parsaileslamlou/Insole/figures/demo/heatmap_sim_walk.gif

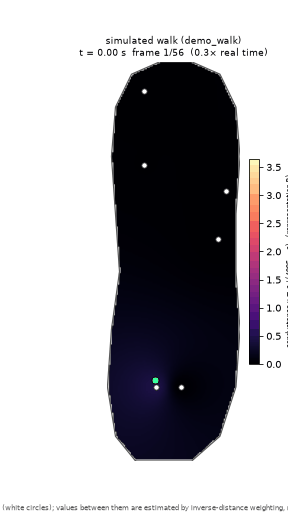
figures/demo/heatmap_sim_walk.gif
