parsaileslamlou/Insole/figures/hardware/board_carrier.jpg

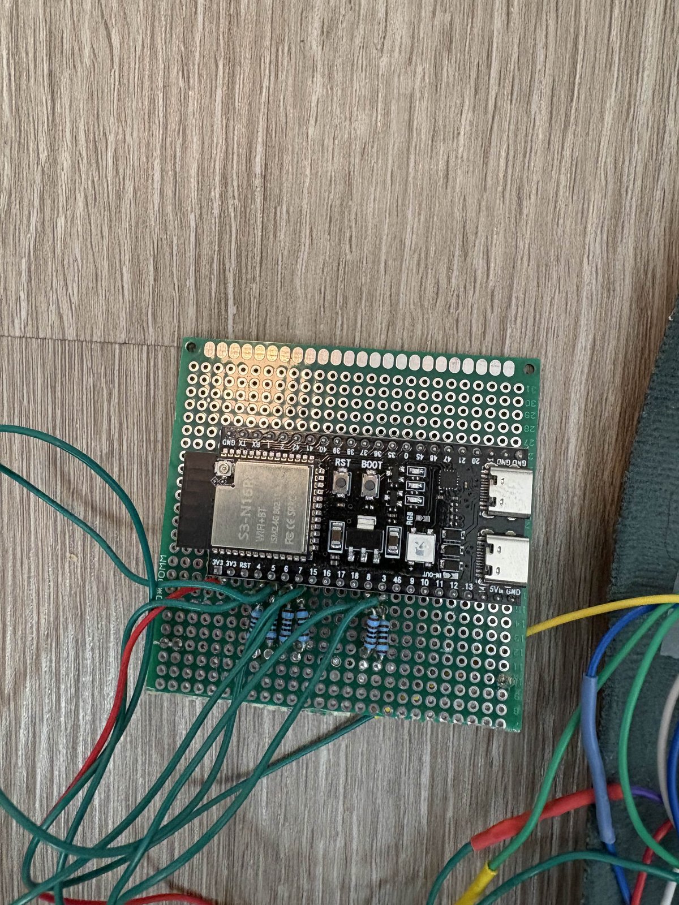
figures/hardware/board_carrier.jpg
