parsaileslamlou/Insole/figures/hardware/insole_sensors.jpg

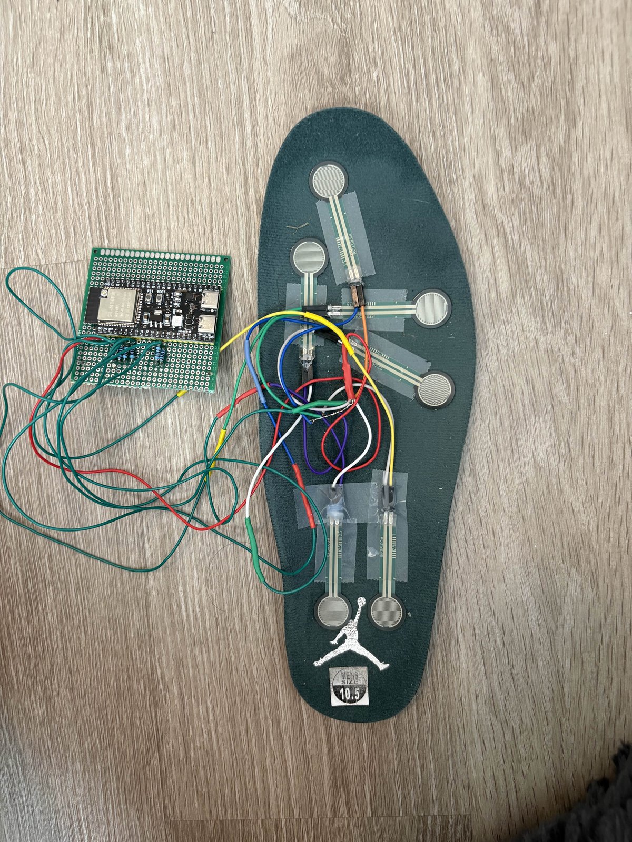
figures/hardware/insole_sensors.jpg
