parsaileslamlou/Insole/figures/sim_vs_real/fast.png

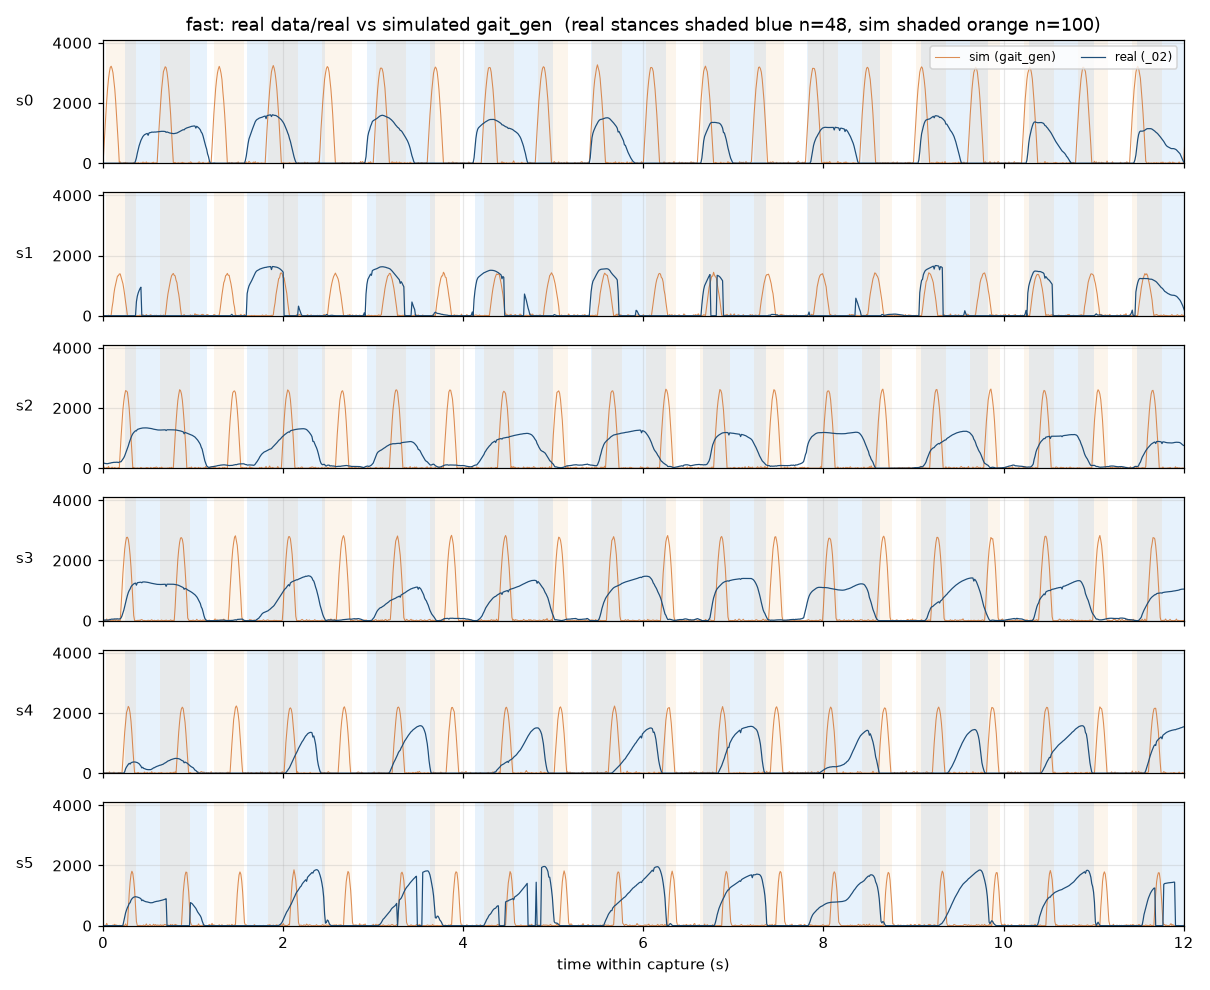
figures/sim_vs_real/fast.png
