parsaileslamlou/Insole/figures/sim_vs_real/shuffle.png

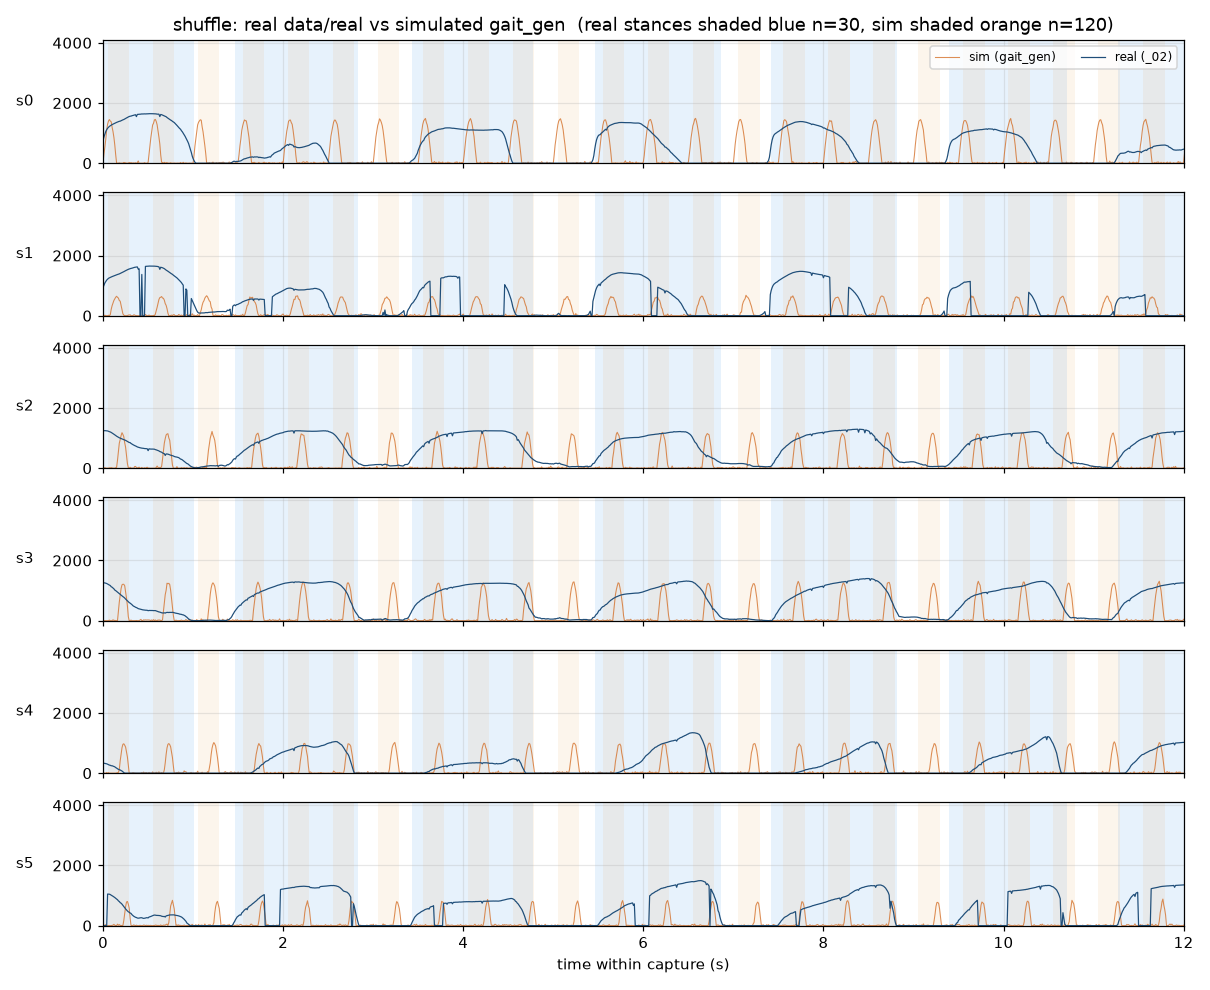
figures/sim_vs_real/shuffle.png
