parsaileslamlou/Insole/figures/sim_vs_real/stand.png

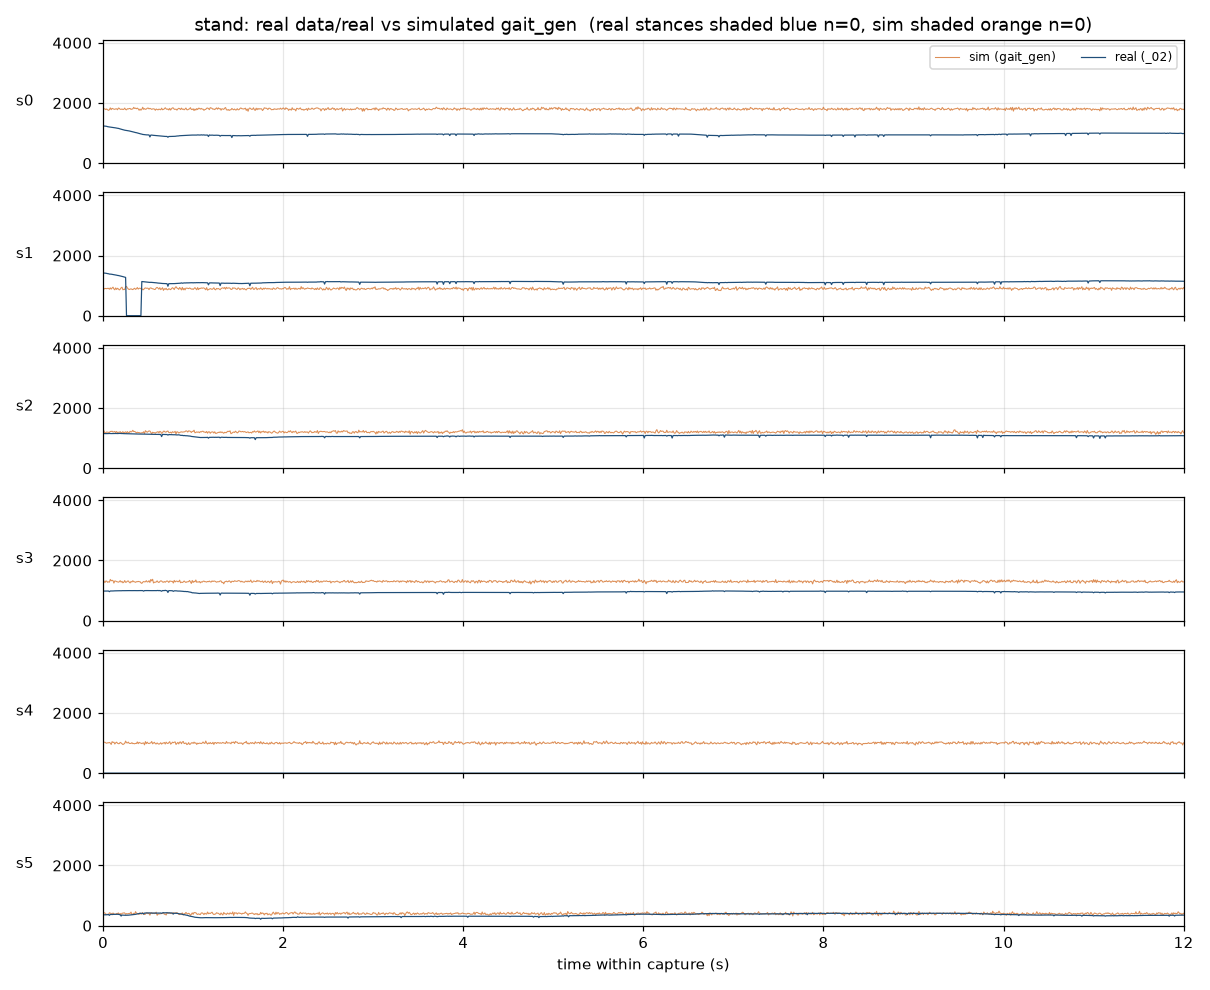
figures/sim_vs_real/stand.png
