parsaileslamlou/Insole/figures/sim_vs_real/walk.png

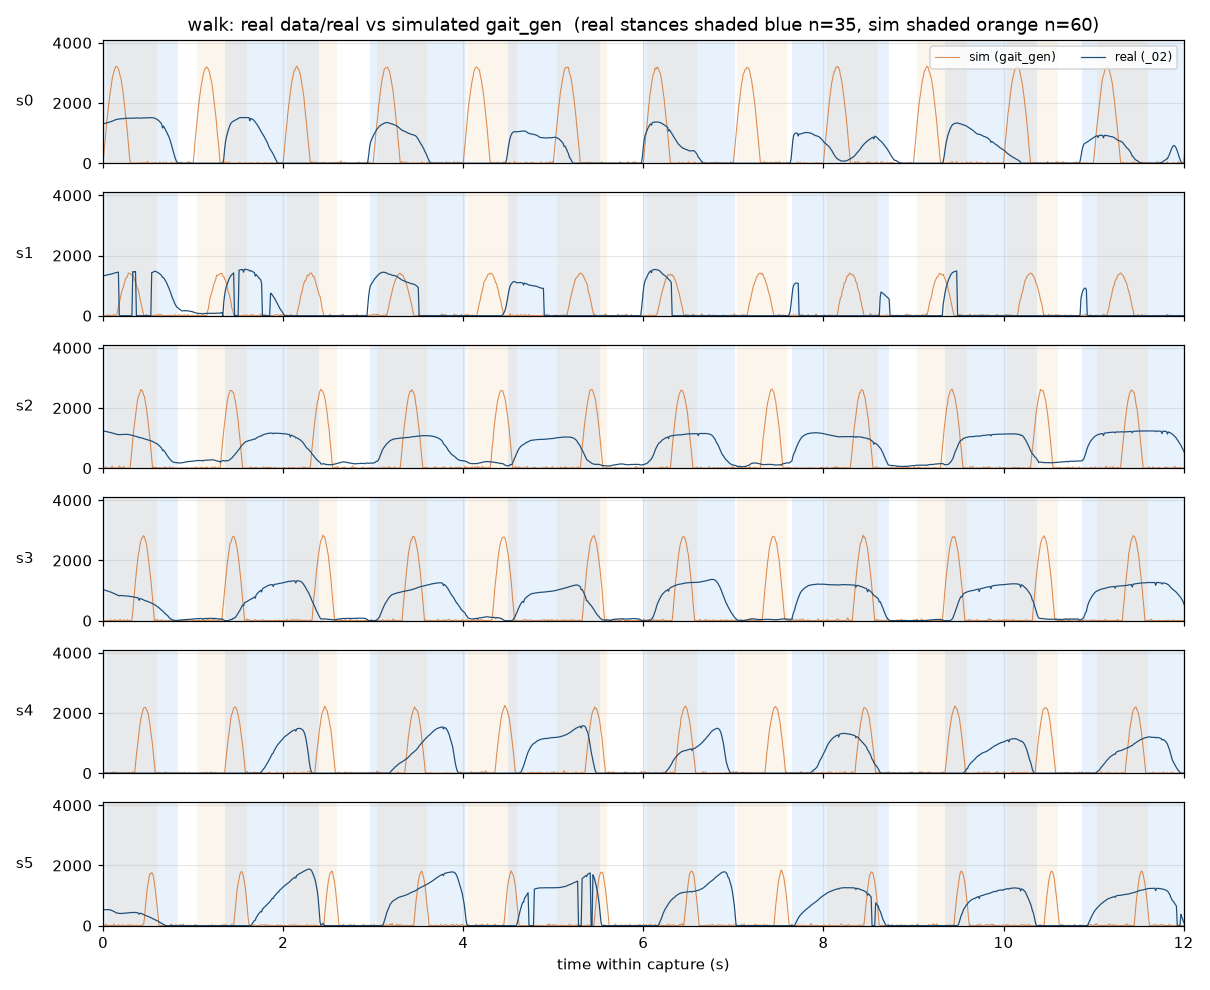
figures/sim_vs_real/walk.png
