parsaileslamlou/Insole/cal_data/calibration_manifest.csv

0 | 0 | cal_s0_t0.csv | 0.0 | 0.0 | 0.0 | 0.0 | 200 | 0.0 | 0.0 | 0.0 | 2026-09-01T19:59:04-04:00
1 | 0 | cal_s1_t0.csv | 0.0 | 0.0 | 0.0 | 0.0 | 200 | 0.0 | 0.0 | 0.0 | 2026-09-01T19:59:12-04:00
2 | 0 | cal_s2_t0.csv | 0.0 | 0.0 | 0.0 | 0.0 | 200 | 0.0 | 0.0 | 0.0 | 2026-09-01T19:59:20-04:00
3 | 0 | cal_s3_t0.csv | 0.0 | 0.0 | 0.0 | 0.0 | 200 | 0.035 | 0.3527 | 0.0 | 2026-09-01T19:59:27-04:00
4 | 0 | cal_s4_t0.csv | 0.0 | 0.0 | 0.0 | 0.0 | 200 | 0.05 | 0.5824 | 0.0 | 2026-09-01T19:59:46-04:00
5 | 0 | cal_s5_t0.csv | 0.0 | 0.0 | 0.0 | 0.0 | 200 | 0.0 | 0.0 | 0.0 | 2026-09-01T20:00:01-04:00
0 | 1 | cal_s0_t1.csv | 664.0 | 683.0 | 6.607035000000001 | 0.05380615833712719 | 200 | 417.825 | 13.0893 | 0.0 | 2026-09-01T20:01:03-04:00
1 | 1 | cal_s1_t1.csv | 652.0 | 668.0 | 6.474600000000001 | 0.04531044912600184 | 200 | 416.66 | 8.4034 | 0.0 | 2026-09-01T20:01:54-04:00
2 | 1 | cal_s2_t1.csv | 598.0 | 631.0 | 6.028245000000001 | 0.09345280132237878 | 200 | 442.645 | 8.446 | 0.0 | 2026-09-01T20:03:03-04:00
3 | 1 | cal_s3_t1.csv | 518.0 | 531.0 | 5.145345000000001 | 0.03681473991487649 | 200 | 476.47 | 8.0806 | 0.0 | 2026-09-01T20:06:47-04:00
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
