parsaileslamlou/Insole/insole/read_serial.py

"""
read_serial.py — host logger for the insole.

Three line sources behind one seam:
    "serial"  live USB CDC          (pyserial)
    "file"    replay a saved capture
    "ble"     live Nordic UART      (bleak)

Everything below make_source() is transport-agnostic: it consumes an iterator
of strings and does not know or care where they came from.

    pip install pyserial bleak

Usage:
    python -m insole.read_serial                          live BLE  -> readings.csv
    python -m insole.read_serial --source ble    out.csv  live BLE  -> out.csv
    python -m insole.read_serial --source serial out.csv  live USB  -> out.csv
    python -m insole.read_serial --source serial --port COM13 --duration 30 out.csv
    python -m insole.read_serial in.txt out.csv           replay a saved capture
    python -m insole.read_serial --source file in.txt out.csv

--port and --duration override PORT and DURATION_S for one run, so a machine
whose board enumerates on a different COM port needs no local edit to this
file.

Both paths are optional. --source defaults to "file" when an input path is
given and "ble" otherwise, so the notebook's
`python -m insole.read_serial data/sim/sim_walk.txt data/sim/sim_walk.csv`
works with no flags.

A live source has no input path, so its single positional is the OUTPUT --
that is what lets compare_captures.py run two captures side by side. --source
has to be given explicitly in that case, because a bare positional still means
"replay this file" and always did.
"""

import sys
import os
import time
import csv
import argparse

# ---------------------------------------------------------------------------
# Configuration. These are DEFAULTS for the CLI below, not the live values.
# The line sources take `duration_s=None` / `port=None` and resolve the module
# attribute AT CALL TIME. An earlier version used `duration_s=DURATION_S` as
# the default argument, which binds at import: assigning
# read_serial.DURATION_S afterwards then changed the runaway guard in main()
# but NOT the capture length, because make_source() had already captured 60.
# That trap is closed by _resolve() below; do not reintroduce it.
# ---------------------------------------------------------------------------
DEFAULT_SOURCE = "ble"      # "serial" | "file" | "ble"

PORT       = "COM7"         # --source serial
BAUD       = 921600
IN_FILE    = "capture.txt"  # --source file, when no in_path is given
BLE_NAME   = "INSOLE"       # --source ble

DURATION_S = 60
OUT_CSV    = "readings.csv"

PERIOD_US  = 10000          # 100 Hz, must match firmware
TIMING_TOL_US = 3000        # how far a gap may stray from its expected value

# Occasional radio drops are normal over BLE and are NOT a defect. Corrupted
# or malformed frames are, on every transport. See exit_code() below.
BLE_LOSS_TOLERANCE_PCT = 2.0

# Data-inactivity watchdog for LIVE sources. A board that stops sending while
# the link stays up -- firmware wedged, radio associated but silent, USB CDC
# stalled -- produces no line, so no counter moves and no check in exit_code()
# can see it. The capture would sit until DURATION_S expires and then exit 0
# with a clean but short file, which is the dataset-ruining mode. Each live
# source raises StallError when no line has arrived for this long. File replay
# is exempt: a file cannot stall.
STALL_S = 3.0

NUS_TX_UUID = "6e400003-b5a3-f393-e0a9-e50e24dcca9e"

SENSOR_COLS = ["s0", "s1", "s2", "s3", "s4", "s5"]
CSV_HEADER  = ["seq", "ts_us"] + SENSOR_COLS

# Lines a source produced but could not hand to the consumer. Raised by any
# source that has a producer thread and a hand-off queue between it and main();
# ble_lines is the only one with such a queue today, but nothing about this is
# BLE-specific and main() prints it without knowing which transport filled it.
# A dict rather than a plain int so a source can mutate it without needing a
# `global` declaration. Reset by main().
SOURCE_DROPS = {"n": 0}


# ---------------------------------------------------------------------------
# Line sources
# ---------------------------------------------------------------------------
class StallError(RuntimeError):
    """A live source produced no line for STALL_S seconds.

    Raised from inside the source generator, so it surfaces in the consumer's
    for-loop and cannot be swallowed by a counter that never moved.
    """


def _resolve(value, default):
    """Call-time default: None means 'whatever the module attribute is now'."""
    return default if value is None else value


def serial_lines(port=None, baud=None, duration_s=None, stall_s=None):
    import serial
    port = _resolve(port, PORT)
    baud = _resolve(baud, BAUD)
    duration_s = _resolve(duration_s, DURATION_S)
    stall_s = _resolve(stall_s, STALL_S)
    # readline() returns b"" after `timeout` seconds of silence; the stall
    # check has to be coarser than that or every quiet second would trip it.
    ser = serial.Serial(port, baud, timeout=min(1.0, stall_s))
    ser.reset_input_buffer()
    t_warm = time.time()
    while time.time() - t_warm < 1.0:      # discard boot chatter
        ser.readline()
    t0 = time.time()
    t_data = t0
    try:
        while time.time() - t0 < duration_s:
            raw = ser.readline()
            if not raw:
                if time.time() - t_data > stall_s:
                    raise StallError(
                        f"serial {port}: no data for {stall_s:.1f}s "
                        f"(port open, board silent)")
                continue
            t_data = time.time()
            yield raw.decode("ascii", errors="ignore").strip()
    finally:
        ser.close()


def file_lines(path):
    with open(path, "r") as f:
        for raw in f:
            yield raw.strip()


def ble_lines(device_name=None, duration_s=None, stall_s=None, _runner=None):
    """Live BLE source.

    All asyncio and threading is confined to this function. It returns a plain
    synchronous generator of strings, exactly like the other two sources.

    `_runner` replaces the BLE session with a caller-supplied coroutine taking
    the output queue. It exists so the failure path below can be exercised
    without a radio, and without bleak installed; nothing in the capture path
    passes it.

    Reassembly contract:
      * A notification may carry several whole lines, one line, or a fragment
        of a line. Nothing may be assumed about alignment.
      * Bytes accumulate in `buf`. We emit only up to the LAST newline in the
        buffer; whatever follows stays buffered until more bytes arrive.
      * At disconnect the trailing partial line is DISCARDED, never emitted.
        Emitting it would produce a short frame that fails the checksum and
        looks like corruption.
      * The hand-off to the consumer never blocks. If the queue is full the
        line is dropped and counted in SOURCE_DROPS, never waited on.
    """
    import asyncio
    import threading
    import queue as _queue

    device_name = _resolve(device_name, BLE_NAME)
    duration_s = _resolve(duration_s, DURATION_S)
    stall_s = _resolve(stall_s, STALL_S)

    out = _queue.Queue(maxsize=20000)
    SENTINEL = object()

    async def _run():
        # Imported here rather than at the top of ble_lines() so a caller that
        # supplies _runner never needs bleak on the machine.
        from bleak import BleakScanner, BleakClient

        buf = bytearray()

        def on_notify(_handle, data):
            buf.extend(data)
            nl = buf.rfind(b"\n")
            if nl < 0:
                return                       # no complete line yet — wait
            chunk = bytes(buf[:nl + 1])
            del buf[:nl + 1]                 # keep the partial tail
            for raw in chunk.split(b"\n"):
                if not raw:
                    continue
                try:
                    out.put_nowait(
                        raw.decode("ascii", errors="ignore").strip())
                except _queue.Full:
                    # This runs on the asyncio event-loop thread. The
                    # blocking put() that used to be here would stall
                    # that thread, which stops notifications being
                    # serviced -- so a stalled consumer costs frames
                    # either way. The difference is that blocking loses
                    # them invisibly, as a gap indistinguishable from
                    # radio loss, while this loses them with a number
                    # attached. maxsize=20000 is ~200 s at 100 Hz, so a
                    # 60 s capture should never reach here; if it does,
                    # the consumer is the problem and the count says so.
                    #
                    # These lines still show up downstream as seq gaps,
                    # so they are already gated by the normal loss
                    # check. The counter is what separates "the radio
                    # dropped them" from "we dropped them ourselves".
                    SOURCE_DROPS["n"] += 1

        # Discovery is timed and reported separately from the capture. It can
        # burn the full 15 s, and charging that against the capture window is
        # what used to make a requested 60 s run quietly yield far less.
        t_scan0 = time.monotonic()
        dev = await BleakScanner.find_device_by_name(device_name, timeout=15.0)
        scan_s = time.monotonic() - t_scan0
        if dev is None:
            print(f"BLE: no device named {device_name!r} found "
                  f"(scanned {scan_s:.1f}s)")
            return

        disconnected = asyncio.Event()

        def on_disconnect(_client):
            disconnected.set()

        async with BleakClient(dev, disconnected_callback=on_disconnect) as client:
            try:
                mtu = client.mtu_size
            except Exception:
                mtu = "unavailable"
            print(f"BLE: connected to {device_name} after {scan_s:.1f}s "
                  f"discovery, negotiated MTU = {mtu}")

            # The notify window opens here, AFTER discovery and connect, so it
            # gets the full duration_s it was asked for.
            t_notify0 = time.monotonic()
            await client.start_notify(NUS_TX_UUID, on_notify)
            try:
                await asyncio.wait_for(disconnected.wait(), timeout=duration_s)
                print("BLE: peripheral disconnected before the duration elapsed")
            except asyncio.TimeoutError:
                pass                          # normal end of capture
            print(f"BLE: notify window {time.monotonic() - t_notify0:.1f}s "
                  f"(requested {duration_s}s)")
            try:
                await client.stop_notify(NUS_TX_UUID)
            except Exception:
                pass

        # buf may still hold a partial line here. It is dropped on purpose.

    # The reader thread's exception, parked until the consumer has drained
    # everything the thread managed to queue before it died. A list because a
    # nested function can append to one without a `nonlocal` declaration.
    failure = []

    def _pump():
        """Run _run() and guarantee the consumer is released, however it ends.

        _run() used to queue SENTINEL itself on each of its exit paths. Any
        path it did not cover -- a bleak connection error, a raise inside the
        notify callback -- left the consumer blocked on out.get() forever:
        a hang with no exit code at all, which is strictly worse than a FAIL.
        The sentinel is now queued in exactly one place, a finally, so no
        future exit path can miss it.

        Releasing the consumer is not the same as reporting the failure. The
        exception is therefore parked rather than swallowed: printing it here
        reports it from a thread nobody is watching, and the consumer re-raises
        it below, so a dead radio produces a traceback and a nonzero exit
        status instead of a short capture that looks clean.

        The reassembly contract in on_notify() is untouched.
        """
        try:
            asyncio.run(_run() if _runner is None else _runner(out))
        except BaseException as exc:             # noqa: BLE001 - park it, never hang
            failure.append(exc)
            print(f"BLE: capture thread failed: {exc!r}")
        finally:
            out.put(SENTINEL)

    threading.Thread(target=_pump, daemon=True).start()

    # Discovery and connect can legitimately take longer than STALL_S, so the
    # watchdog arms at the first line, not at start. Before that the only
    # timeout is bleak's own 15 s scan inside _run().
    armed = False
    while True:
        try:
            item = out.get(timeout=stall_s if armed else None)
        except _queue.Empty:
            raise StallError(
                f"ble {device_name}: no data for {stall_s:.1f}s "
                f"(connected, no notifications)")
        if item is SENTINEL:
            break
        armed = True
        yield item

    if failure:
        # Raised only after every queued line has been yielded, so surfacing
        # the failure never costs us the frames that did arrive before it.
        raise failure[0]


def make_source(source, in_path=None, duration_s=None, port=None, stall_s=None):
    """The seam. Everything past here consumes an iterator of strings.

    None for duration_s / port / stall_s means the module attribute as it is
    at CALL time (DURATION_S / PORT / STALL_S) -- see the configuration note.
    """
    if source == "serial":
        return serial_lines(port=port, duration_s=duration_s, stall_s=stall_s)
    if source == "file":
        if in_path is None:
            raise ValueError("source 'file' requires an input path")
        return file_lines(in_path)
    if source == "ble":
        return ble_lines(duration_s=duration_s, stall_s=stall_s)
    raise ValueError(f"unknown source {source!r}")


# ---------------------------------------------------------------------------
# Frame validation
# ---------------------------------------------------------------------------
def parse_frame(line):
    """Return (row, reason). row is None when the line is not a valid frame.

    A leading '#' is a firmware status line (`# ble conn=... mtu=...`), not
    corruption. Tolerating it here as well as in main() means a direct caller
    of parse_frame() gets the same answer the capture loop does.
    """
    if line.startswith("#"):
        return None, "status"
    parts = line.split(",")
    if len(parts) != 10 or parts[0] != "INS":
        return None, "malformed"
    try:
        nums = [int(p) for p in parts[1:]]
    except ValueError:
        return None, "malformed"

    seq, ts_us = nums[0], nums[1]
    vals, ck = nums[2:8], nums[8]

    if (sum(nums[:8]) % 256) != ck:
        return None, "bad_checksum"
    if any(v < 0 or v > 4095 for v in vals):
        return None, "malformed"

    return (seq, ts_us, vals), None


# ---------------------------------------------------------------------------
# Main
# ---------------------------------------------------------------------------
def build_parser():
    p = argparse.ArgumentParser(
        description="Capture insole frames from USB serial, BLE, or a saved file.")
    p.add_argument("in_path", nargs="?", default=None,
                   help="capture to replay; giving it implies --source file")
    p.add_argument("out_path", nargs="?", default=None,
                   help=f"output CSV (default: {OUT_CSV}). For a live source "
                        f"this is the FIRST positional, not the second.")
    p.add_argument("--source", choices=("serial", "file", "ble"), default=None,
                   help="transport; defaults to 'file' when in_path is given, "
                        "else '%s'" % DEFAULT_SOURCE)
    p.add_argument("--port", default=None,
                   help=f"serial port for --source serial (default: {PORT})")
    p.add_argument("--duration", type=float, default=None, metavar="SECONDS",
                   help=f"live capture length (default: DURATION_S = {DURATION_S})")
    return p


def _same_file(a, b):
    """True if two path strings name the same file, before either is opened.

    normcase() because on Windows 'Capture.TXT' and 'capture.txt' are one
    file. os.path.samefile() is not usable here: out_path does not exist yet.
    """
    return (os.path.normcase(os.path.abspath(a))
            == os.path.normcase(os.path.abspath(b)))


def resolve_args(argv=None):
    """Bind the two optional positionals to (in_path, out_path) per source.

    argparse fills positionals left to right, so `--source ble out.csv` puts
    out.csv in in_path -- the wrong slot, because a live source has no input
    path. The old code spotted the mismatch and REFUSED the argument, which
    left no way at all to name the output file for a live capture. That is
    exactly what compare_captures.py needs two of, so the one script whose
    whole purpose is proving BLE reassembly could not be run. Re-bind rather
    than refuse.

    The restriction that ban was standing in for is real but much narrower:
    under --source file both paths are given and must not be the same file,
    or opening out_path for writing truncates the input before it is read.
    That is now checked as the collision it actually is, on the resolved
    paths, so `capture.txt ./capture.txt` is caught too.
    """
    args = build_parser().parse_args(argv)

    if args.source is None:
        args.source = "file" if args.in_path else DEFAULT_SOURCE

    if args.source == "file":
        if args.in_path is None:
            args.in_path = IN_FILE
    else:
        # No input path exists for a live source, so a lone positional is the
        # output. Two positionals is a real mistake and still an error.
        if args.out_path is not None:
            build_parser().error(
                f"--source {args.source} takes at most one path, the output "
                f"CSV; got two: {args.in_path!r} and {args.out_path!r}")
        args.out_path, args.in_path = args.in_path, None

    if args.out_path is None:
        args.out_path = OUT_CSV

    if args.source == "file" and _same_file(args.in_path, args.out_path):
        build_parser().error(
            f"in_path and out_path are the same file ({args.in_path!r}); "
            f"the replay would truncate its own input")

    return args


class FrameValidator:
    """The per-line validation and accounting main() does, as one object.

    infer_live.py runs the same checks on the same lines, so they live here
    once. feed(line) returns (seq, ts_us, vals) for a valid frame and None for
    anything else, and bumps exactly the counters main() used to bump inline:

        valid, malformed, empty, bad_checksum, status,
        seq_breaks, lost, timing_breaks

    plus first_ts / last_ts (device clock) for the span report. The host-clock
    bookkeeping stays in the caller, because only the caller knows what clock
    it is on (test_capture_window substitutes a fake one).

    Fault policy (README "Fault handling"; gait_gen's fault modes exercise it):

      unrecoverable frame   a bad checksum or a frame that never arrived is
                            DROPPED and COUNTED. No row is produced, nothing
                            is reconstructed. A corrupt frame still consumed
                            a sequence number, so the gap it leaves is
                            credited to bad_checksum and NOT also to lost:
                            valid + lost + bad_checksum equals the frames the
                            board emitted (up to frames lost at a reset
                            boundary, which no host can see).
      reset                 the device clock runs backwards: the board
                            rebooted and re-latched t0 (SEQ restarts too, but
                            the first post-reset frame may itself have been
                            lost, so the clock is the signature). Counted once
                            in `resets`; the sequence and timing validators
                            are re-seeded from that frame, and the
                            discontinuity is NOT also counted as a seq break,
                            loss or timing break -- those describe a link that
                            dropped or delayed frames, a different fault.

    After feed() returns a row, last_gap is the number of sequence slots
    missing immediately before it -- lost OR rejected, because a stance with
    a hole in it has a hole either way -- and last_reset says whether it is
    the first frame after a reset. infer_live.py reads both: the first flags
    a stance that spans a gap, the second discards the stance in progress.
    """

    def __init__(self):
        self.c = dict(valid=0, malformed=0, empty=0, bad_checksum=0,
                      seq_breaks=0, timing_breaks=0, status=0, lost=0, resets=0)
        self.prev_seq = None
        self.prev_ts = None
        self.first_ts = None     # device clock (ts_us) at the first valid frame
        self.last_ts = None      # device clock at the last valid frame
        self.rejected_since_valid = 0   # bad-checksum frames since the last valid one
        self.last_gap = 0
        self.last_reset = False

    def feed(self, line):
        c = self.c
        if not line:
            c["empty"] += 1
            return None
        if line.startswith("#"):          # firmware status line, not a frame
            c["status"] += 1
            return None

        row, reason = parse_frame(line)
        if row is None:
            c[reason] += 1
            if reason == "bad_checksum":
                # A well-formed frame with the wrong checksum occupied a
                # sequence slot. Malformed lines are not credited: boot text
                # (no slot) and a truncated frame (one slot) look the same.
                self.rejected_since_valid += 1
            return None

        seq, ts_us, vals = row
        self.last_gap = 0
        self.last_reset = False

        if self.prev_seq is not None:
            if ts_us < self.prev_ts:
                c["resets"] += 1
                self.last_reset = True
            else:
                # uint16 sequence, wraps every 65536 frames (~11 min at 100 Hz)
                delta = (seq - self.prev_seq) % 65536
                if delta != 1:
                    missing = max(delta - 1, 0)          # slots absent, any reason
                    gap = max(missing - self.rejected_since_valid, 0)
                    if gap or delta == 0:
                        c["seq_breaks"] += 1
                    c["lost"] += gap
                    self.last_gap = missing
                # Expected time gap scales with the number of frames spanned,
                # so a dropped frame is counted ONCE (as loss) and not a
                # second time as a timing fault.
                if delta > 0:
                    expected = PERIOD_US * delta
                    if abs((ts_us - self.prev_ts) - expected) > TIMING_TOL_US:
                        c["timing_breaks"] += 1

        self.rejected_since_valid = 0
        self.prev_seq, self.prev_ts = seq, ts_us
        if self.first_ts is None:
            self.first_ts = ts_us
        self.last_ts = ts_us
        c["valid"] += 1
        return row

    def loss_pct(self):
        expected_total = self.c["valid"] + self.c["lost"]
        return (100.0 * self.c["lost"] / expected_total) if expected_total else 0.0


def main(argv=None):
    args = resolve_args(argv)
    duration_s = _resolve(args.duration, DURATION_S)

    v = FrameValidator()
    c = v.c

    SOURCE_DROPS["n"] = 0       # per run, so an in-process second call is clean

    t_first = None      # host clock at the first line of any kind
    t_last = None       # host clock at the last valid frame
    stalled = None

    with open(args.out_path, "w", newline="") as f:
        w = csv.writer(f)
        w.writerow(CSV_HEADER)

        source = make_source(args.source, args.in_path,
                             duration_s=duration_s, port=args.port)
        try:
            for line in source:
                now = time.time()
                # This guard exists to stop a live source that never ends. It
                # runs from the FIRST LINE, not from process start, so time
                # spent discovering and connecting is not charged against the
                # capture window -- that is what silently shortened BLE runs.
                # Anchoring on the first line is transport-agnostic on
                # purpose: serial_lines() also burns a second on boot chatter
                # before its first line.
                if t_first is None:
                    t_first = now
                elif now - t_first > duration_s + 5:
                    break

                if line.startswith("#"):      # echo status lines as they pass
                    print(line)

                row = v.feed(line)
                if row is None:
                    continue

                seq, ts_us, vals = row
                if v.last_reset:
                    print(f"reset: board rebooted at host t={now - t_first:.1f}s "
                          f"(SEQ and ts_us restarted); rows continue in the same file")
                t_last = now
                w.writerow([seq, ts_us] + vals)
        except StallError as exc:
            stalled = str(exc)

    first_ts, last_ts = v.first_ts, v.last_ts
    loss_pct = v.loss_pct()

    # Two spans, deliberately both reported, because they are different clocks:
    #   capture_s  host wall clock, first valid frame -> last. What the session
    #              actually cost, and the number to compare against DURATION_S.
    #   device_s   the board's own ts_us span. Immune to transport jitter and
    #              batching, so a gap between the two is a link story, not a
    #              sampling story.
    capture_s = (t_last - t_first) if (t_first is not None and t_last is not None) else 0.0
    device_s = ((last_ts - first_ts) / 1e6) if (first_ts is not None and last_ts is not None) else 0.0

    print(f"source={args.source} valid={c['valid']} malformed={c['malformed']} "
          f"empty={c['empty']} bad_checksum={c['bad_checksum']} "
          f"seq_breaks={c['seq_breaks']} lost={c['lost']} "
          f"loss={loss_pct:.2f}% timing_breaks={c['timing_breaks']} "
          f"resets={c['resets']} status={c['status']} "
          f"source_drops={SOURCE_DROPS['n']} "
          f"capture_s={capture_s:.1f} device_s={device_s:.1f}")

    # source_drops is the host throwing lines away because its own hand-off
    # queue was full -- our fault, not the radio's. It is reported rather than
    # gated because the frames it loses already reach exit_code() as seq gaps.
    # Saying so explicitly stops a full queue being read as a bad link.
    if SOURCE_DROPS["n"]:
        print(f"NOTE: {SOURCE_DROPS['n']} lines dropped at the source hand-off "
              f"(consumer could not keep up); they are counted in lost above")

    # A short session should be visible, not inferred from a low frame count.
    # Reporting only -- it does not change the exit code. Live sources only:
    # a file replay finishes in well under DURATION_S by design.
    if args.source != "file" and capture_s < duration_s - 1.0:
        print(f"NOTE: capture ran {capture_s:.1f}s, {duration_s - capture_s:.1f}s "
              f"short of the requested {duration_s}s")

    # A stall is a hard failure whatever the counters say: the frames written
    # so far are fine, but the capture is not the one that was asked for, and
    # exit 0 here is exactly the silent mode the watchdog exists to remove.
    if stalled:
        print(f"FAIL: stalled -- {stalled}")
        return 1

    return exit_code(c, loss_pct, args.source)


def exit_code(c, loss_pct, source):
    """Transport-aware gating.

    Two classes of anomaly, and they are not the same kind of thing:

      CORRUPTION  malformed, bad_checksum, empty
          Never acceptable on any transport. A checksum failure over BLE means
          the reassembly logic is wrong, not that the radio is busy. Zero
          tolerance, always.

      LOSS        whole frames that never arrived (seq gaps)
          On USB this means the firmware or the host stalled — a real defect.
          On BLE this is the radio doing what radios do. Gated on a RATE, not
          a count, so the check still means something: a capture that loses 30%
          of its frames still fails.

      RESET       the board rebooted mid-capture (device clock ran backwards)
          Never acceptable on any transport: the ts_us axis restarts, so the
          file is two captures glued together, not the one that was asked
          for. Its boot text usually also lands in `malformed`, but over
          native USB CDC or BLE the boot text never reaches the host and the
          clock is the only evidence, so this is gated on its own.
    """
    if c["malformed"] or c["bad_checksum"] or c["empty"]:
        print("FAIL: corrupted frames present")
        return 1

    if c["resets"]:
        print(f"FAIL: board reset mid-capture ({c['resets']}x; SEQ and ts_us restarted)")
        return 1

    if c["valid"] == 0:
        print("FAIL: no valid frames")
        return 1

    if source == "ble":
        if loss_pct > BLE_LOSS_TOLERANCE_PCT:
            print(f"FAIL: BLE frame loss {loss_pct:.2f}% "
                  f"exceeds tolerance {BLE_LOSS_TOLERANCE_PCT}%")
            return 1
        # timing_breaks over BLE that are NOT explained by loss are still real
        if c["timing_breaks"]:
            print("FAIL: timing breaks not explained by frame loss")
            return 1
        return 0

    # serial / file: unchanged strictness
    if c["lost"] or c["seq_breaks"] or c["timing_breaks"]:
        print("FAIL: sequence or timing anomaly")
        return 1
    return 0


if __name__ == "__main__":
    # main() returns the code rather than calling sys.exit() itself, so every
    # FAIL branch in exit_code() lands here and every failure leaves a nonzero
    # status. It also makes main() callable in-process without SystemExit.
    sys.exit(main())
