parsaileslamlou/Insole/insole/detector.py

"""Stance detection on total-force streams.

This lives in a file, not a notebook cell, so that both the notebook and
test_stances.py import the same definition. Copying the detector into the
test would let the two drift until the test passes against a stale detector.

Failure taxonomy used in the comments below:
  fragmentation  - one true event becomes N detections   (1 FN + N-1 FP)
  annihilation   - one true event becomes 0 detections   (1 FN, precision looks clean)
  merging        - N true events become 1 detection      (N-1 FN)
  boundary error - 1 detection, wrong edges              (invisible to P/R)

Geometry, and what is authoritative about it:

  The authoritative insole boundary is the 274 x 91 mm RECTANGLE defined by
  INSOLE_LEN_MM and INSOLE_WIDTH_MM below. Every sensor coordinate is measured
  against that rectangle and normalised by its length.

  heatmap.FOOT_OUTLINE is NOT authoritative. It is a hand-drawn, decorative
  foot silhouette -- a rendering aid, digitised in arbitrary units and merely
  rescaled onto the rectangle's bounding box. It was never measured against
  this insole and carries no calibration.

  That distinction has a consequence, because heatmap.FOOT_MASK is derived
  from the silhouette rather than from the rectangle: the drawn foot pinches
  in where a real foot narrows, so a sensor sitting near the rectangle's edge
  can fall close to (or outside) the silhouette even though it is squarely on
  the insole. Its interpolated field is then clipped in the render. That is a
  cosmetic artifact of the drawing, not a statement about the sensor. s3, at
  81.3 of 91 mm across the width, is the sensor this applies to -- it clears
  the outline by roughly 7 mm, which is inside the +/-15 mm measurement
  uncertainty on its own position.

  Nothing in the CoP path consults FOOT_OUTLINE. cop_frame uses SENSOR_COORDS
  only, so a clipped render never changes a computed number.
"""

SENSOR_COLS = ["s0", "s1", "s2", "s3", "s4", "s5"]

# --- insole geometry ---------------------------------------------
# Measured outline of the physical insole: 274 x 91 mm (10.8 x 3.6 in).
# An earlier 295 x 74 mm figure circulated in these docs and was wrong in
# both axes -- the insole is shorter and considerably wider than that.
INSOLE_LEN_MM   = 274.0
INSOLE_WIDTH_MM = 91.0

# Sensor centres in millimetres on a RIGHT insole lying top-up:
#   y measured from the heel end, increasing toward the toe
#   x measured from the MEDIAL edge, so x = 0 is medial, x = 91 is lateral
#
# Measurement uncertainty: two independent passes over the same six sensors
# disagreed by 12-22 mm, so treat every number below as +/-15 mm. That is
# ~5% of the insole length and ~16% of its width; any CoP figure derived
# from these coordinates inherits it and should be quoted with it.
SENSOR_MM = {
    "s0": (33.0,  50.8),
    "s1": (50.8,  50.8),
    "s2": (76.2, 152.4),
    "s3": (81.3, 185.4),
    "s4": (25.4, 203.2),
    "s5": (25.4, 254.0),
}

# Derived from SENSOR_MM, never hand-typed -- decimals typed twice drift.
#
# BOTH axes are divided by INSOLE_LEN_MM, not each by its own extent.
# Normalising x by the width instead would stretch the short axis by
# 274/91 = 3.01 and distort every distance, angle and CoP path length
# computed on these points. Dividing both by the same constant is a
# similarity transform: shape is preserved, and multiplying any coordinate
# by 274 recovers millimetres.
#
# The price is that x spans only [0, 91/274] = [0, 0.332] rather than the
# full unit interval. heatmap.py's FOOT_OUTLINE is rescaled to that same
# box; the two must move together or the sensors render outside the foot.
SENSOR_COORDS = {
    name: (x_mm / INSOLE_LEN_MM, y_mm / INSOLE_LEN_MM)
    for name, (x_mm, y_mm) in SENSOR_MM.items()
}

# --- detector constants ------------------------------------------
# Every value here is hardware-sensitive. All five were picked by measuring
# the simulated streams, not by guessing. The measurements they rest on:
#
#   stream    truth dur   in-stance peak   in-stance trough   between-stance peak
#   walk        62 fr       7637..7874        950..1137              213
#   fast        37 fr       7617..7847       1371..1558              285
#   shuffle     31 fr       3384..3596        596.. 790              220
#   dropout     62 fr       7623..7812          0..1147              219
#   standing     -          6381..6824             (never falls)       -
#
# MAX_DURATION is the exception: it was re-set from REAL data afterwards.
# See its comment below.
#
T_ON         = 1200   # RETUNE: entry threshold, total force across six channels.
                      # Must clear the 285 between-stance noise peak but sit well
                      # under the shuffle stance peak (~3400). At 2000 the shuffle
                      # spends only ~12 frames above it, under MIN_DURATION, and
                      # every shuffle stance is annihilated.
T_OFF        =  450   # RETUNE: exit threshold; must be < T_ON or the state machine
                      # chatters. Binding constraint is the shuffle midstance
                      # trough (596): above it, every shuffle stance fragments.
MIN_DURATION =   15   # RETUNE: frames; must be BELOW the shortest stance you intend
                      # to support. Shortest detected stance is the shuffle at 25
                      # frames. Still rejects the single-frame noise spike, which
                      # is what this guard was actually for.
MAX_DURATION =  200   # RETUNE: frames; must be ABOVE the longest real stance
                      # and below "standing" (unbounded). Was 120, set from the
                      # longest SIMULATED stance (58 frames). The real _02
                      # captures (data/real/, analyze_real.py C5) showed natural
                      # contacts of 84..144 frames walking and 96..164 shuffling,
                      # so 120 discarded 17/35 walk and 28/30 shuffle contacts
                      # outright. 200 = 2.0 s at 100 Hz: 22% above the longest
                      # observed contact (164) and 30x below the one thing it
                      # exists to reject, the 6000-frame standing run. Every
                      # value from 165 to 1000 gives identical counts on all
                      # four real captures and all five sim fixtures; 200 is
                      # the round one. No sim stance exceeds 60 frames, so the
                      # sim tests cannot see this change -- it rests on four
                      # minutes of real data from one subject.
GAP_MERGE    =   12   # RETUNE: frames; two detections closer than this are one
                      # stance. Tightest true separation is the shuffle at 19
                      # frames of truth / ~24 frames as detected, so this must
                      # stay under ~24 or it merges genuine adjacent shuffle steps.


def find_stances(total, t_on=T_ON, t_off=T_OFF,
                 min_duration=MIN_DURATION, max_duration=MAX_DURATION):
    """Two-state hysteresis detector over a total-force sequence.

    Returns a list of inclusive (start_idx, end_idx) pairs.
    """
    stances = []
    in_stance = False
    start = 0
    # Cleared by a max_duration break. While False, re-entry is blocked until
    # force has actually fallen below t_off at least once. Without this latch,
    # max_duration alone converts the standing annihilation into 25 back-to-back
    # bogus stances -- i.e. it trades one failure bucket for a worse one.
    armed = True
    i = -1

    for i, x in enumerate(total):
        if in_stance:
            if x < t_off:
                if i - start >= min_duration:
                    stances.append((start, i - 1))
                in_stance = False
            elif i - start >= max_duration:
                # Longer than any real stance: this is standing, or a sensor
                # stuck high. Discard rather than emit -- emitting would report
                # standing as a stance, which is the failure being fixed.
                in_stance = False
                armed = False
        else:
            if not armed:
                if x < t_off:
                    armed = True
            elif x >= t_on:
                start = i
                in_stance = True

    # A stance still open when the recording ends is a real stance. The old
    # loop dropped it as a side effect of its shape, not as a decision.
    #
    # This is also why max_duration is load-bearing rather than cosmetic. The
    # old loop scored standing correctly (0 stances) only by accident: force
    # never fell below t_off, so the open stance was silently discarded at EOF.
    # Emitting it here without the max_duration break turns 60 s of standing
    # into one 6000-frame "stance".
    if in_stance and min_duration <= i - start + 1 <= max_duration:
        stances.append((start, i))

    return stances


def merge_close(stances, gap=GAP_MERGE):
    """Join detections separated by fewer than `gap` frames.

    This is the fragmentation fix: a stance whose midstance trough dips below
    t_off is split in two, and this glues it back together with both true
    outer boundaries intact.

    Chosen over a refractory lockout because a lockout blocks *entry* for R
    frames after a stance ends, which (a) just re-enters a few frames later if
    force is still above t_on -- turning a visible fragmentation into an
    invisible boundary error -- and (b) needs R above the trough width but
    below the shortest stride interval, a window that narrows with cadence.

    Ordering caveat: find_stances drops sub-min_duration runs before this ever
    sees them, so merge_close can only rejoin fragments that individually clear
    min_duration. If a trough splits a stance into two pieces both shorter than
    min_duration, the failure is annihilation, not fragmentation, and no amount
    of gap merging recovers it -- t_off has to come down instead.
    """
    if not stances:
        return []
    out = [stances[0]]
    for start, end in stances[1:]:
        prev_start, prev_end = out[-1]
        if start - prev_end - 1 < gap:
            out[-1] = (prev_start, end)
        else:
            out.append((start, end))
    return out


def _overlap(x, y):
    return max(0, min(x[1], y[1]) - max(x[0], y[0]) + 1)


def stance_report(detected, truth):
    """Mean boundary and duration error, in frames, over matched pairs.

    This is the only instrument that can see a boundary error. Counts, and
    therefore precision and recall, are blind to it forever -- a detector that
    finds every stance but clips 15% off each contact time scores 1.000.
    Print this beside every P/R number.
    """
    empty = {"n_matched": 0, "mean_start_offset": float("nan"),
             "mean_end_offset": float("nan"), "mean_duration_error": float("nan")}
    if not detected or not truth:
        return empty

    claimed = set()
    start_offsets, end_offsets, duration_errors = [], [], []
    for d in detected:
        best, best_ov = None, 0
        for j, t in enumerate(truth):
            if j in claimed:
                continue
            ov = _overlap(d, t)
            if ov > best_ov:
                best, best_ov = j, ov
        if best is None:
            continue
        claimed.add(best)
        t = truth[best]
        start_offsets.append(d[0] - t[0])
        end_offsets.append(d[1] - t[1])
        duration_errors.append((d[1] - d[0] + 1) - (t[1] - t[0] + 1))

    if not start_offsets:
        return empty
    n = len(start_offsets)
    return {
        "n_matched": n,
        "mean_start_offset": sum(start_offsets) / n,
        "mean_end_offset": sum(end_offsets) / n,
        "mean_duration_error": sum(duration_errors) / n,
    }


# ---------------------------------------------------------------------------
# Streaming twin of find_stances + merge_close
# ---------------------------------------------------------------------------
class StanceTracker:
    """find_stances() and merge_close(), one frame at a time.

    infer_live.py cannot call find_stances on a stream: it needs the stance
    the moment it closes, and it needs to know about the stances find_stances
    throws away, because on real data those were most of them (MAX_DURATION
    at 120 discarded 17/35 walk and 28/30 shuffle contacts). This class runs
    the identical state machine incrementally and REPORTS every decision
    instead of silently dropping the losers.

    Contract, checked by test_infer_live.py on every sim fixture, every sim
    session, every real capture and a few thousand random sequences:

        [(s, e) for kind, s, e in events if kind == "stance"]
            == merge_close(find_stances(total))

    when every value of `total` is pushed in order and flush() is called at
    the end. Same thresholds, same inclusive (start, end) pairs, same latch.

    push(x) returns a list of events for this frame, each a tuple
    (kind, start, end):

        "stance"         a merged stance is final. Nothing that arrives later
                         can change it. This is the only kind that reaches
                         the feature extractor.
        "discarded_max"  a run reached max_duration and was thrown away,
                         exactly as find_stances does (standing, or a stuck
                         sensor). end is the frame the break fired on.
        "rejected_min"   a run ended before min_duration. Noise spike.

    Event latency: a stance is held back until the merge window closes, i.e.
    until the frame index passes end + gap without a new run starting inside
    it. That is at most GAP_MERGE frames (120 ms at 100 Hz) after the run
    ends, plus the next run's own length if a mergeable run does start.

    The one thing this cannot reproduce until it is told the input has ended
    is find_stances's EOF rule: an open run at end of input is a stance if
    its length is within [min, max]. flush() applies that rule. A live source
    calls it when the capture window closes.

    State that crosses a read boundary lives here and nowhere else: in_stance,
    armed, start, and the pending (not yet merge-final) stance. The caller
    only feeds frames.
    """

    def __init__(self, t_on=T_ON, t_off=T_OFF, min_duration=MIN_DURATION,
                 max_duration=MAX_DURATION, gap=GAP_MERGE):
        self.t_on = t_on
        self.t_off = t_off
        self.min_duration = min_duration
        self.max_duration = max_duration
        self.gap = gap
        self.i = -1
        self.in_stance = False
        self.armed = True
        self.start = 0
        self.pending = None          # (start, end) merged-so-far, not yet final
        self.n_stances = 0
        self.n_discarded_max = 0
        self.n_rejected_min = 0
        self.n_discarded_reset = 0

    def reset(self):
        """The board rebooted between the last frame and the next.

        Returns the events that boundary settles. A pending stance -- complete,
        waiting out its merge window -- is released as a stance: nothing on the
        far side of a reset can merge into it. The run in progress is thrown
        away and reported as "discarded_reset": its frames before the reset
        are real, but its end is not observable, and a truncated stance fed to
        the classifier would look like a whole one. Re-entry is then blocked
        until force falls below t_off, exactly as after a max_duration discard,
        so the remainder of the split stance is not reported as a fresh short
        one either. The frame index keeps counting; the caller's index space is
        its own.
        """
        events = []
        if self.pending is not None:
            p_start, p_end = self.pending
            self.pending = None
            self.n_stances += 1
            events.append(("stance", p_start, p_end))
        if self.in_stance:
            self.in_stance = False
            self.n_discarded_reset += 1
            events.append(("discarded_reset", self.start, self.i))
        self.armed = False
        return events

    # -- the two pieces of find_stances, kept in its order --------------------
    def _raw_stance(self, start, end):
        """A run find_stances would have appended. Apply merge_close to it."""
        if self.pending is not None:
            p_start, p_end = self.pending
            if start - p_end - 1 < self.gap:
                self.pending = (p_start, end)
                return []
            self.n_stances += 1
            self.pending = (start, end)
            return [("stance", p_start, p_end)]
        self.pending = (start, end)
        return []

    def _release_pending(self):
        """Emit the pending stance once no future run can merge into it.

        merge_close joins a run starting at s into the previous stance ending
        at e iff s - e - 1 < gap, i.e. s <= e + gap. Not in a run at index i
        means any future run starts at >= i + 1, so nothing can merge once
        i + 1 > e + gap.
        """
        if self.pending is None or self.in_stance:
            return []
        p_start, p_end = self.pending
        if self.i + 1 > p_end + self.gap:
            self.pending = None
            self.n_stances += 1
            return [("stance", p_start, p_end)]
        return []

    def push(self, x):
        self.i += 1
        i = self.i
        events = []
        if self.in_stance:
            if x < self.t_off:
                if i - self.start >= self.min_duration:
                    events += self._raw_stance(self.start, i - 1)
                else:
                    self.n_rejected_min += 1
                    events.append(("rejected_min", self.start, i - 1))
                self.in_stance = False
            elif i - self.start >= self.max_duration:
                self.in_stance = False
                self.armed = False
                self.n_discarded_max += 1
                events.append(("discarded_max", self.start, i))
        else:
            if not self.armed:
                if x < self.t_off:
                    self.armed = True
            elif x >= self.t_on:
                self.start = i
                self.in_stance = True
        events += self._release_pending()
        return events

    def flush(self):
        """End of input: find_stances's EOF rule, then release what is pending."""
        events = []
        i = self.i
        if self.in_stance:
            length = i - self.start + 1
            if self.min_duration <= length <= self.max_duration:
                events += self._raw_stance(self.start, i)
            self.in_stance = False
        if self.pending is not None:
            p_start, p_end = self.pending
            self.pending = None
            self.n_stances += 1
            events.append(("stance", p_start, p_end))
        return events

    def earliest_live_index(self):
        """Lowest frame index a future event can still reference, or None.

        A caller keeping a frame buffer for feature extraction can drop every
        frame below this. It is the start of the run in progress or of the
        pending stance, whichever is earlier.
        """
        idxs = []
        if self.in_stance:
            idxs.append(self.start)
        if self.pending is not None:
            idxs.append(self.pending[0])
        return min(idxs) if idxs else None
