parsaileslamlou/Insole/scripts/train_real.py

"""A classifier trained on the real captures, with the analysis behind it.

    python scripts/train_real.py

Writes docs/real_results.md, figures/real_results/*.png and
models/model_{lda,qda}_real.json. Every number in the document is computed
here; regenerate it rather than editing it. Seeded, deterministic, and it
runs from a fresh clone in well under a minute.

What it does, in order:
  1. loads every training-grade capture in data/real/ (labels and sets from
     data/real/README.md; _01 is failure evidence and is skipped), segments
     each with detector.py at the committed thresholds on RAW counts, and
     checks each file's stance count against its pin in SESSIONS below. A
     capture with no pin stops the run and says so: adding a session means
     pinning it, here and in tests/test_stances.py. Stand yields no stances
     and is excluded from classification.
  2. computes features.py's extractors under three input representations
     (insole/representations.py): A raw counts, B conductance, C gain-matched
     conductance; and two feature sets: CoP-only (the set the sim bake-off
     used) and the full seven.
  3. splits leave-one-session-out once every class has two or more sessions:
     fold k holds out session k of every class, every stance is tested once
     out of its own session, and the headline pools the folds. Beside it, so
     the within-session optimism is visible: the time-blocked split within
     each session (first 60 % of stances train, last 40 % test) and a random
     stance-level split (20 seeds). With one session per class the
     time-blocked split is the headline instead, with contiguous-block
     cross-validation and the random split beside it.
  4. fits LDA and QDA (insole/discriminant.py) and sklearn logistic regression
     (as scripts/bakeoff.py does) for every representation x feature set,
     and chooses ONE headline cell by a rule fixed before any result was
     seen: CoP-only features, the representation and the model (LDA or QDA)
     with the best pooled leave-one-session-out accuracy (best contiguous-
     block CV accuracy in the one-session case), ties to raw counts and LDA.
     That cell's leave-one-session-out (or time-blocked) accuracy is the
     headline.
  5. lists every misclassified test stance, draws it, and quantifies the
     mechanisms behind each confusion pair; checks peak force against onset
     time per session; measures what the gain match changes; compares the
     sim-trained models on the same stances.
"""

import argparse
import json
import os
import re
import subprocess
import sys
import time
import warnings
from collections import Counter, OrderedDict

import numpy as np
import pandas as pd

import matplotlib
matplotlib.use("Agg")
import matplotlib.pyplot as plt                                    # noqa: E402
from scipy import stats                                            # noqa: E402
from sklearn.linear_model import LogisticRegression                # noqa: E402
from sklearn.pipeline import make_pipeline                         # noqa: E402
from sklearn.preprocessing import StandardScaler                   # noqa: E402

from insole import calibration as C                                # noqa: E402
from insole import detector as D                                   # noqa: E402
from insole.discriminant import (                                  # noqa: E402
    DegenerateClassError, IllConditionedCovarianceWarning, SingularCovarianceError,
    accuracy_ci, fit_lda, fit_qda, load_model, predict, save_model,
)
from insole.features import cop_frame                              # noqa: E402
from insole.paths import DATA_REAL, DOCS, FIGURES, MODELS, REPO    # noqa: E402
from insole.representations import (                               # noqa: E402
    LETTER, REPRESENTATIONS, SHIPPED, features_under, gains_from_doc, transform_frames,
)
from insole.splits import (                                        # noqa: E402
    contiguous_block_folds, leave_one_session_out, random_stance_splits,
    sessions_per_class, time_blocked_split,
)

# Every training-grade capture, as captured (data/real/README.md): label,
# file, and the stance count detector.find_stances + merge_close gives it at
# the committed thresholds. The count is a per-file pin, not a per-label total,
# so a new session never changes an old pin and an unpinned file is refused
# rather than silently trained on. tests/test_stances.py pins the same counts
# independently. _01 is failure evidence and is not listed.
SESSIONS = [
    ("stand",   "stand_02.csv",   0),
    ("walk",    "walk02.csv",    35),
    ("fast",    "fast02.csv",    48),
    ("shuffle", "shuffle02.csv", 30),
    ("stand",   "stand_03.csv",   0),
    ("walk",    "walk_03.csv",   32),
    ("fast",    "fast_03.csv",   45),
    ("shuffle", "shuffle_03.csv", 34),
]
LABELS = ("stand", "walk", "fast", "shuffle")
CLASSES = ["fast", "shuffle", "walk"]                  # np.unique order
COP_FEATURES = ["cop_path_len", "cop_displacement"]     # scripts/bakeoff.py FEATURES
FULL_FEATURES = ["peak_counts", "time_to_peak_s", "contact_time_s",
                 "loading_rate_cps", "impulse_counts_s",
                 "cop_path_len", "cop_displacement"]
FEATURE_SETS = OrderedDict([("cop", COP_FEATURES), ("full", FULL_FEATURES)])
MODEL_KINDS = ("lda", "qda", "lr")
TRAIN_FRAC = 0.6
N_RANDOM = 20
N_BLOCKS = 5
SEED = 0
MM = D.INSOLE_LEN_MM                                    # normalised units -> mm
S4 = D.SENSOR_COLS.index("s4")

RULE = "=" * 78


def head(t):
    print("\n" + RULE + "\n" + t + "\n" + RULE)


def git_hash():
    try:
        return subprocess.run(["git", "rev-parse", "--short", "HEAD"], cwd=REPO,
                              capture_output=True, text=True, check=True).stdout.strip()
    except Exception:                                    # noqa: BLE001
        return "unknown"


# ---------------------------------------------------------------------------
# 1. Data
# ---------------------------------------------------------------------------
def discover_sessions(real_dir):
    """Pinned files that exist, in SESSIONS order, then any unpinned <label>*.csv.

    Returns (pinned, unpinned): pinned as (label, fname, expected_stances),
    unpinned as (label, fname). _01 files and check_all are never candidates.
    """
    pinned, seen = [], set()
    for label, fname, want in SESSIONS:
        if os.path.exists(os.path.join(real_dir, fname)):
            pinned.append((label, fname, want))
            seen.add(fname)
    unpinned = []
    for fname in sorted(os.listdir(real_dir)):
        if not fname.endswith(".csv") or fname in seen or "_01" in fname or "check_all" in fname:
            continue
        for label in LABELS:
            if fname.startswith(label):
                unpinned.append((label, fname))
    return pinned, unpinned


def segment(real_dir, fname):
    df = pd.read_csv(os.path.join(real_dir, fname))
    total = df[D.SENSOR_COLS].sum(axis=1).to_numpy(dtype=float)
    return df, total, D.merge_close(D.find_stances(total))


def load_sessions(real_dir):
    """-> (sessions, unpinned). Each session carries its pin; unpinned is [(fname, n_stances)]."""
    pinned, unpinned = discover_sessions(real_dir)
    out = []
    for label, fname, want in pinned:
        df, total, stances = segment(real_dir, fname)
        out.append(dict(label=label, session=fname[:-4], file=fname, df=df,
                        total=total, stances=stances, expected=want))
    extra = [(fname, len(segment(real_dir, fname)[2])) for _label, fname in unpinned]
    return out, extra


def build_frames(sessions, gains):
    """{rep: feature frame}; identical row order across representations."""
    frames = {}
    for rep in REPRESENTATIONS:
        parts = []
        for s in sessions:
            if s["label"] == "stand" or not s["stances"]:
                continue
            f = features_under(s["df"], s["stances"], s["label"], rep,
                               gains if rep == "gain_matched" else None)
            ts = s["df"]["ts_us"].to_numpy()
            f["session"] = s["session"]
            f["onset_s"] = [(ts[a] - ts[0]) / 1e6 for a, _ in s["stances"]]
            f["s4_zero_frac"] = [float((s["df"]["s4"].to_numpy()[a:b + 1] == 0).mean())
                                 for a, b in s["stances"]]
            parts.append(f)
        frames[rep] = pd.concat(parts, ignore_index=True)
    return frames


# ---------------------------------------------------------------------------
# 2. Models
# ---------------------------------------------------------------------------
def fit_predict(kind, Xtr, ytr, Xte):
    """-> (pred, note) or (None, reason). Standardisation only for LR, as bakeoff.py."""
    if kind == "lr":
        pipe = make_pipeline(StandardScaler(), LogisticRegression(max_iter=5000))
        pipe.fit(Xtr, ytr)
        return pipe.predict(Xte), ""
    try:
        with warnings.catch_warnings(record=True) as caught:
            warnings.simplefilter("always")
            m = fit_lda(Xtr, ytr) if kind == "lda" else fit_qda(Xtr, ytr)
            pred = predict(m, Xte)
    except DegenerateClassError as e:
        return None, f"DegenerateClassError: {e}"
    except SingularCovarianceError as e:
        return None, f"SingularCovarianceError: {e}"
    n_ill = sum(issubclass(w.category, IllConditionedCovarianceWarning) for w in caught)
    return pred, (f"{n_ill} ill-conditioned covariance warning(s)" if n_ill else "")


def evaluate(kind, frame, feats, train_idx, test_idx):
    """Fit on train_idx, score on test_idx. A stance with a non-finite value in
    `feats` is excluded from this cell (both sides) and counted in
    n_excluded; features.py returns NaN for loading_rate_cps when the peak is
    the first frame of a stance, which a capture that starts mid-contact
    produces. The stance stays in every cell whose features are finite."""
    X = frame[feats].to_numpy(float)
    y = frame["label"].to_numpy()
    finite = np.isfinite(X).all(axis=1)
    train_idx, test_idx = np.asarray(train_idx), np.asarray(test_idx)
    tr = train_idx[finite[train_idx]]
    te = test_idx[finite[test_idx]]
    excluded = set(train_idx[~finite[train_idx]].tolist()) | set(test_idx[~finite[test_idx]].tolist())
    if len(te) == 0:
        return dict(skipped="no test stance with finite features")
    pred, note = fit_predict(kind, X[tr], y[tr], X[te])
    if pred is None:
        return dict(skipped=note)
    r = score(pred, y[te], te, note)
    r["excluded"] = excluded                      # distinct stances left out of this cell
    r["n_excluded"] = len(excluded)
    return r


def score(pred, yte, test_idx, note=""):
    """Accuracy with its Wilson interval, confusion, precision and recall."""
    acc, lo, hi, se = accuracy_ci(yte, pred)
    labs = CLASSES
    conf = [[int(((yte == t) & (pred == q)).sum()) for q in labs] for t in labs]
    prec, rec = {}, {}
    for lab in labs:
        tp = int(((yte == lab) & (pred == lab)).sum())
        fp = int(((yte != lab) & (pred == lab)).sum())
        fn = int(((yte == lab) & (pred != lab)).sum())
        prec[lab] = tp / (tp + fp) if tp + fp else float("nan")
        rec[lab] = tp / (tp + fn) if tp + fn else float("nan")
    return dict(acc=acc, lo=lo, hi=hi, se=se, n_correct=int((pred == yte).sum()),
                n_test=len(yte), pred=pred, yte=yte, test_idx=test_idx,
                conf=conf, precision=prec, recall=rec, note=note)


def evaluate_folds(kind, frame, feats, folds):
    """Pooled out-of-fold result over [(train_idx, test_idx, held_out), ...].

    Every stance is tested exactly once; the pooled predictions get the same
    treatment as one test set (accuracy_ci over every tested stance), and
    each fold's own accuracy and interval ride along under "folds".
    """
    preds, ytes, idxs, per_fold = [], [], [], []
    for tr, te, held in folds:
        r = evaluate(kind, frame, feats, tr, te)
        if "skipped" in r:
            return dict(skipped=r["skipped"])
        preds.append(r["pred"])
        ytes.append(r["yte"])
        idxs.append(r["test_idx"])
        per_fold.append(dict(held_out=list(held), n_train=len(tr), n_test=len(te),
                             acc=r["acc"], lo=r["lo"], hi=r["hi"],
                             n_correct=r["n_correct"], note=r["note"],
                             excluded=r["excluded"]))
    notes = sorted({f["note"] for f in per_fold if f["note"]})
    out = score(np.concatenate(preds), np.concatenate(ytes), np.concatenate(idxs), "; ".join(notes))
    out["folds"] = per_fold
    out["excluded"] = set().union(*(f["excluded"] for f in per_fold))
    out["n_excluded"] = len(out["excluded"])
    return out


def cv_accuracy(kind, frame, feats, folds):
    """Pooled accuracy over folds (every stance tested once) and per-fold list."""
    correct = total = 0
    per_fold = []
    for tr, te in folds:
        r = evaluate(kind, frame, feats, tr, te)
        if "skipped" in r:
            return float("nan"), [], r["skipped"]
        correct += r["n_correct"]
        total += r["n_test"]
        per_fold.append(r["acc"])
    return correct / total, per_fold, ""


def random_summary(kind, frame, feats):
    accs = []
    for tr, te in random_stance_splits(frame, TRAIN_FRAC, N_RANDOM, SEED):
        r = evaluate(kind, frame, feats, tr, te)
        if "skipped" in r:
            return float("nan"), float("nan"), float("nan"), r["skipped"]
        accs.append(r["acc"])
    return float(np.mean(accs)), float(np.min(accs)), float(np.max(accs)), ""


def mcnemar(a_pred, b_pred, yte):
    ok_a, ok_b = a_pred == yte, b_pred == yte
    b = int((ok_a & ~ok_b).sum())
    c = int((~ok_a & ok_b).sum())
    if b + c == 0:
        return b, c, float("nan")
    return b, c, float(stats.binomtest(b, b + c, 0.5).pvalue)


def holm(pvals):
    """Holm-Bonferroni adjusted p-values, returned in the input order.

    Sort ascending, multiply the k-th smallest by (m - k), then enforce
    monotonicity and cap at 1. Holm controls the family-wise error rate under
    ARBITRARY dependence between the tests, which is what section 8's family
    needs: the pooled per-class regressions and the per-session ones are fitted
    on overlapping stances and are not independent, so a method that assumes
    independence (Sidak, Benjamini-Hochberg's independence form) would not be
    valid here and Holm is.
    """
    m = len(pvals)
    order = sorted(range(m), key=lambda i: pvals[i])
    adj, running = [0.0] * m, 0.0
    for rank, i in enumerate(order):
        running = max(running, (m - rank) * float(pvals[i]))
        adj[i] = min(1.0, running)
    return adj


def overlap_fraction(a, b):
    """How much of two intervals coincide, as a fraction of each one's length.

    Reported so "the intervals overlap" is a measured statement rather than an
    impression. -> (overlap_len / len(a), overlap_len / len(b)).
    """
    lo, hi = max(a[0], b[0]), min(a[1], b[1])
    ov = max(0.0, hi - lo)
    return (ov / (a[1] - a[0]) if a[1] > a[0] else float("nan"),
            ov / (b[1] - b[0]) if b[1] > b[0] else float("nan"))


# The one caveat that has to travel with every pooled interval this script
# prints, and with every copy of those numbers in README.md, docs/writeup.md
# and notebooks/demo.ipynb. It names the specific violation rather than
# gesturing at "small sample": the pooled Wilson interval is computed as if the
# tested stances were independent draws, and they are not.
def ci_caveat(n_pooled, n_sessions, n_subjects=1):
    return (
        f"**The pooled interval is a LOWER BOUND on the uncertainty, not a confidence "
        f"interval for a new session.** It is a Wilson interval computed as if the "
        f"{n_pooled} pooled stances were {n_pooled} independent observations. They are "
        f"not. They are {n_pooled} stances drawn from {n_sessions} sessions of "
        f"{n_subjects} subject, and stances within one session share the subject, the "
        f"day, the shoe, the sensor seating and the figure-8 path, so they are "
        f"positively correlated; the effective number of independent observations is "
        f"nearer the number of sessions than the number of stances. Treating "
        f"correlated observations as independent understates the variance, so the true "
        f"interval is WIDER than the one printed, by an amount this data cannot "
        f"quantify: correcting it needs the between-session variance, and "
        f"{n_sessions} sessions estimate that from {n_sessions} points "
        f"({n_sessions - 1} degree{'s' if n_sessions != 2 else ''} of freedom), which is "
        f"not an estimate. The per-fold intervals are reported beside the pooled one "
        f"for exactly this reason: they are the widest honest statement available here. "
        f"Read the pooled interval as the floor of the uncertainty, never as its extent."
    )


# ---------------------------------------------------------------------------
# 3. Mechanism measurements
# ---------------------------------------------------------------------------
def cop_mm(vals6):
    """CoP in mm for an (n, 6) array of channel values (any representation)."""
    out = np.full((len(vals6), 2), np.nan)
    for i, v in enumerate(vals6):
        row = dict(zip(D.SENSOR_COLS, v))
        x, y = cop_frame(row)
        out[i] = (x * MM, y * MM)
    return out


def stance_frames(sessions, label=None):
    """(n, 6) raw counts of every frame inside a kept stance, per session."""
    for s in sessions:
        if s["label"] == "stand" or (label and s["label"] != label):
            continue
        vals = s["df"][D.SENSOR_COLS].to_numpy(dtype=float)
        for a, b in s["stances"]:
            yield s, vals[a:b + 1]


def gain_effect_mm(sessions, gains, fs):
    """Mean |CoP(C) - CoP(A)| over stance frames, per class, in mm."""
    out = {}
    for lab in CLASSES:
        d = []
        for _, v in stance_frames(sessions, lab):
            a = cop_mm(v)
            c = cop_mm(transform_frames(v, "gain_matched", gains, fs))
            ok = ~np.isnan(a[:, 0]) & ~np.isnan(c[:, 0])
            d.append(np.hypot(*(c[ok] - a[ok]).T))
        d = np.concatenate(d)
        out[lab] = (float(d.mean()), float(np.median(d)))
    return out


def s4_zero_effect_mm(sessions, substitute):
    """On stance frames where s4 == 0: CoP with s4 := substitute minus actual, per class."""
    out = {}
    for lab in CLASSES:
        d, n, tot = [], 0, 0
        for _, v in stance_frames(sessions, lab):
            z = (v[:, S4] == 0) & (v.sum(axis=1) > 0)
            tot += len(v)
            n += int(z.sum())
            if z.any():
                w = v[z].copy()
                w[:, S4] = substitute
                d.append(np.hypot(*(cop_mm(w) - cop_mm(v[z])).T))
        d = np.concatenate(d) if d else np.array([np.nan])
        out[lab] = (float(np.nanmean(d)), n / tot if tot else float("nan"))
    return out


def ml_spread_mm(sessions):
    """Stance-to-stance sd of the mean medial-lateral CoP position, per class (mm)."""
    out = {}
    for lab in CLASSES:
        means = [np.nanmean(cop_mm(v)[:, 0]) for _, v in stance_frames(sessions, lab)]
        out[lab] = float(np.std(means, ddof=1))
    return out


def band_overlap(frame, feats, train_idx):
    """Fraction of each class's stances inside another class's p10-p90 band (train)."""
    out = {}
    tr = frame.loc[train_idx]
    for f in feats:
        bands = {lab: np.percentile(tr.loc[tr["label"] == lab, f], [10, 90]) for lab in CLASSES}
        for a in CLASSES:
            va = frame.loc[frame["label"] == a, f].to_numpy()
            for b in CLASSES:
                if a == b:
                    continue
                lo, hi = bands[b]
                out[(f, a, b)] = float(((va >= lo) & (va <= hi)).mean())
    return out


# ---------------------------------------------------------------------------
# 4. Figures
# ---------------------------------------------------------------------------
def fig_feature_distributions(frame, feats, path):
    fig, axes = plt.subplots(1, len(feats), figsize=(4.2 * len(feats), 3.6))
    axes = np.atleast_1d(axes)
    colors = {"fast": "#E07A3F", "shuffle": "#7A5CC7", "walk": "#378ADD"}
    rng = np.random.default_rng(SEED)
    for ax, f in zip(axes, feats):
        for i, lab in enumerate(CLASSES):
            v = frame.loc[frame["label"] == lab, f].to_numpy()
            ax.scatter(i + rng.uniform(-0.18, 0.18, len(v)), v, s=14, alpha=0.7,
                       color=colors[lab], label=f"{lab} (n={len(v)})")
            ax.hlines(np.median(v), i - 0.3, i + 0.3, color="black", lw=1.2)
        ax.set_xticks(range(len(CLASSES)))
        ax.set_xticklabels(CLASSES)
        ax.set_title(f)
        ax.grid(alpha=0.3)
    axes[0].legend(fontsize=7)
    fig.suptitle("Per-class feature distributions, all stances (bar = median)")
    fig.tight_layout()
    fig.savefig(path, dpi=110)
    plt.close(fig)


def fig_errors(sessions, rows, rep, gains, fs, path, title):
    """One figure per confusion pair: total-force trace and CoP path per stance.

    At most MAX_ERROR_PANELS stances are drawn (the first that many in test
    order); the document's table lists every one.
    """
    if len(rows) > MAX_ERROR_PANELS:
        title += f" (first {MAX_ERROR_PANELS} of {len(rows)} drawn)"
        rows = rows[:MAX_ERROR_PANELS]
    n = len(rows)
    fig, axes = plt.subplots(2, n, figsize=(2.9 * n, 6.2), squeeze=False)
    by_session = {s["session"]: s for s in sessions}
    for j, r in enumerate(rows):
        s = by_session[r["session"]]
        a, b = int(r["start"]), int(r["end"])
        vals = s["df"][D.SENSOR_COLS].to_numpy(dtype=float)[a:b + 1]
        t = np.arange(len(vals)) / 100.0
        axes[0, j].plot(t, vals.sum(axis=1), color="0.2", lw=1.2)
        axes[0, j].plot(t, vals[:, S4], color="#E07A3F", lw=0.9, label="s4")
        axes[0, j].set_title(f"{r['session']} @ {r['onset_s']:.1f}s", fontsize=8)
        axes[0, j].set_xlabel("s")
        if j == 0:
            axes[0, j].set_ylabel("total counts (s4 in orange)")
            axes[0, j].legend(fontsize=7)
        cp = cop_mm(transform_frames(vals, rep, gains, fs))
        ax = axes[1, j]
        ax.plot([0, D.INSOLE_WIDTH_MM, D.INSOLE_WIDTH_MM, 0, 0], [0, 0, MM, MM, 0], color="0.6", lw=0.8)
        for name, (x, y) in D.SENSOR_MM.items():
            ax.scatter([x], [y], s=12, color="0.5")
        ax.plot(cp[:, 0], cp[:, 1], color="#1D9E75", lw=1.2)
        ok = ~np.isnan(cp[:, 0])
        if ok.any():
            ax.scatter(cp[ok][0, 0], cp[ok][0, 1], s=22, color="#1D9E75", marker="o")
            ax.scatter(cp[ok][-1, 0], cp[ok][-1, 1], s=22, color="#1D9E75", marker="s")
        ax.set_aspect("equal")
        ax.set_xlim(-5, D.INSOLE_WIDTH_MM + 5)
        ax.set_ylim(-5, MM + 5)
        ax.set_xlabel("medial -> lateral (mm)")
        ax.set_title(f"path {r['cop_path_len']:.2f} disp {r['cop_displacement']:.2f}", fontsize=8)
        if j == 0:
            ax.set_ylabel("heel -> toe (mm)")
    fig.suptitle(title)
    fig.tight_layout()
    fig.savefig(path, dpi=110)
    plt.close(fig)


def fig_peak_vs_onset(frame, trends, path):
    fig, axes = plt.subplots(1, 3, figsize=(12, 3.4))
    for ax, lab in zip(axes, CLASSES):
        sub = frame[frame["label"] == lab]
        ax.scatter(sub["onset_s"], sub["peak_counts"], s=14, color="0.25")
        sl, ic, r, p = trends[lab]
        xs = np.array([sub["onset_s"].min(), sub["onset_s"].max()])
        ax.plot(xs, ic + sl * xs, color="#E07A3F", lw=1.2)
        ax.set_title(f"{lab}: slope {sl:+.1f} counts/s, r={r:+.2f}, p={p:.3f}", fontsize=9)
        ax.set_xlabel("stance onset (s into the capture)")
        ax.grid(alpha=0.3)
    axes[0].set_ylabel("peak total force (raw counts)")
    fig.tight_layout()
    fig.savefig(path, dpi=110)
    plt.close(fig)


# ---------------------------------------------------------------------------
# 5. Main
# ---------------------------------------------------------------------------
def fmt_ci(r):
    return (f"{r['acc']:.4f} [{r['lo']:.4f}, {r['hi']:.4f}] ({r['n_correct']}/{r['n_test']})"
            + (f" ({r['n_excluded']} excl.)" if r.get("n_excluded") else ""))


def name_excluded(r, frame):
    """'`shuffle_03` at t = 0.00 s' for every stance a cell had to drop."""
    idx = sorted(r.get("excluded", ()))
    return ", ".join(f"`{frame.at[i, 'session']}` at t = {frame.at[i, 'onset_s']:.2f} s"
                     for i in idx)


def denominators(cop_r, full_r, frame):
    """The sentence that has to travel with the two headline numbers TOGETHER.

    They are computed on different test sets. The CoP-only headline uses every
    stance; the full-feature cell drops any stance with a non-finite feature,
    which on this data is one. Printing the two accuracies side by side without
    both denominators invites the reader to difference them as if they were
    measured on the same stances, and they were not. So the denominators, the
    excluded stance and the reason are repeated at EVERY co-occurrence of the
    two numbers -- in this document, in README.md, in docs/writeup.md and in
    notebooks/demo.ipynb -- not only at first mention.
    """
    n_cop, n_full = cop_r["n_test"], full_r["n_test"]
    if n_cop == n_full:
        return f"Both numbers are on the same n = {n_cop} stances."
    who = name_excluded(full_r, frame)
    return (
        f"**The two headline numbers are on different denominators: the CoP-only "
        f"{cop_r['acc']:.4f} is on n = {n_cop}, the full-feature {full_r['acc']:.4f} on "
        f"n = {n_full}.** {n_cop - n_full} stance ({who}) begins at the first frame of its "
        f"capture, so it has no pre-onset frames, `loading_rate_cps` is undefined there and "
        f"`features.py` returns NaN rather than imputing a value. Any cell whose feature set "
        f"includes that feature drops the stance from both sides of the split; the CoP-only "
        f"cells do not use it and keep it. The stance is named and dropped, never filled in. "
        f"Differencing {cop_r['acc']:.4f} and {full_r['acc']:.4f} therefore compares two "
        f"accuracies measured on test sets that are not the same set.")


MAX_ERROR_PANELS = 12                                   # per confusion-pair figure


def set_suffix(fname):
    """'walk02.csv' -> '02', 'walk_03.csv' -> '03': the capture set a file belongs to."""
    m = re.search(r"(\d+)\.csv$", fname)
    return m.group(1) if m else "?"


def main(argv=None):
    ap = argparse.ArgumentParser(description=__doc__.split("\n")[0])
    ap.add_argument("--real-dir", default=str(DATA_REAL))
    ap.add_argument("--gain", default=str(MODELS / "gain_match.json"))
    ap.add_argument("--doc", default=str(DOCS / "real_results.md"))
    ap.add_argument("--fig-dir", default=str(FIGURES / "real_results"))
    ap.add_argument("--models-dir", default=str(MODELS))
    ap.add_argument("--guard", type=int, default=0,
                    help="stances dropped from the end of each training block of the "
                         "time-blocked split (default 0)")
    args = ap.parse_args(argv)
    # The document is written UTF-8 explicitly; the console echo of it must not
    # depend on the console's codepage. Windows defaults stdout to cp1252, which
    # cannot encode the U+2212 minus and the U+2192 arrows this document uses,
    # and the script died on the echo rather than on anything it measures.
    try:
        sys.stdout.reconfigure(encoding="utf-8")
    except (AttributeError, OSError):                     # pragma: no cover
        pass
    os.makedirs(args.fig_dir, exist_ok=True)
    os.makedirs(args.models_dir, exist_ok=True)
    os.makedirs(os.path.dirname(args.doc), exist_ok=True)
    t_start = time.time()
    md = []                                          # the document, line by line

    def out(s=""):
        print(s)
        md.append(s)

    gm = C.load_gain_match(args.gain)
    gains = gains_from_doc(gm)
    fs = float(gm["fs_counts"])

    # -- 1. data -----------------------------------------------------------
    head("1  DATA -- every training-grade capture, segmented on raw counts")
    sessions, unpinned = load_sessions(args.real_dir)
    bad = []
    for s in sessions:
        ok = len(s["stances"]) == s["expected"]
        print(f"  {s['label']:8s} {s['file']:16s} frames={len(s['df'])} "
              f"stances={len(s['stances'])} pinned={s['expected']}" + ("" if ok else "  <-- MISMATCH"))
        if not ok:
            bad.append(s)
    if bad:
        raise SystemExit("stance count does not match its pin at MAX_DURATION="
                         f"{D.MAX_DURATION}: " + ", ".join(
                             f"{s['file']} got {len(s['stances'])} pinned {s['expected']}" for s in bad)
                         + ". Either the detector moved or the pin is wrong; decide which, "
                         "then fix that (SESSIONS here, REAL_COUNTS in tests/test_stances.py).")
    if unpinned:
        raise SystemExit("captures in the real-data directory with no stance pin: " + ", ".join(
            f"{f} ({n} stances)" for f, n in unpinned)
            + ". Add each to SESSIONS in scripts/train_real.py and to REAL_COUNTS in "
            "tests/test_stances.py, then rerun.")
    sets = sorted({set_suffix(s["file"]) for s in sessions})
    frames = build_frames(sessions, gains)
    frame_a = frames["raw"]
    n_all = len(frame_a)
    y_all = frame_a["label"].to_numpy()
    spc = sessions_per_class(frame_a)
    multi_session = all(len(v) >= 2 for v in spc.values())
    all_floor_lab, all_floor_n = Counter(y_all).most_common(1)[0]
    all_floor = all_floor_n / n_all
    print(f"  moving stances: {n_all}  sessions per class: { {k: len(v) for k, v in spc.items()} }")

    # -- 2. splits ---------------------------------------------------------
    head("2  SPLITS")
    tb_train, tb_test, tb_per_class = time_blocked_split(frame_a, TRAIN_FRAC, args.guard)
    tb_name = (f"time-blocked within each session: first {TRAIN_FRAC:.0%} of stances "
               f"train, last {1 - TRAIN_FRAC:.0%} test, guard band {args.guard}")
    if multi_session:
        folds = list(leave_one_session_out(frame_a))
        fold_pc = []
        for tr, te, held in folds:
            fold_pc.append((held, {lab: (int((frame_a.loc[tr, "label"] == lab).sum()),
                                         int((frame_a.loc[te, "label"] == lab).sum()))
                                   for lab in CLASSES}, len(tr), len(te)))
        split_name = f"leave-one-session-out, {len(folds)} folds, pooled over the folds"
        metric_name = "leave-one-session-out"
        print(f"  every class has >= 2 sessions: {split_name}")
        for k, (held, pc, ntr, nte) in enumerate(fold_pc):
            print(f"    fold {k}: held out {held}: " + "  ".join(
                f"{lab} train {pc[lab][0]:3d} test {pc[lab][1]:3d}" for lab in CLASSES)
                + f"  (n_train={ntr} n_test={nte})")
        print(f"  every stance is tested exactly once, out of its own session: pooled n_test={n_all}, "
              f"majority floor {all_floor:.4f} ({all_floor_n}/{n_all}, always '{all_floor_lab}')")
        print(f"  reported beside it: {tb_name} (pooled over sessions): " + "  ".join(
            f"{lab} train {tb_per_class[lab][0]:3d} test {tb_per_class[lab][1]:3d}" for lab in CLASSES))
        train_idx, test_idx, per_class = None, None, None
        floor, floor_lab, floor_n = all_floor, all_floor_lab, all_floor_n
        block_folds = None
    else:
        folds = None
        train_idx, test_idx, per_class = tb_train, tb_test, tb_per_class
        split_name = tb_name
        metric_name = "time-blocked"
        print("  ONE session per class: no per-session split is possible. Using " + split_name)
        for lab in CLASSES:
            print(f"    {lab:8s} train {per_class[lab][0]:3d}  test {per_class[lab][1]:3d}  "
                  f"dropped {per_class[lab][2]}")
        yte_all = frame_a.loc[test_idx, "label"].to_numpy()
        floor_lab, floor_n = Counter(yte_all).most_common(1)[0]
        floor = floor_n / len(yte_all)
        print(f"  n_train={len(train_idx)} n_test={len(test_idx)}  test majority floor = "
              f"{floor:.4f} ({floor_n}/{len(test_idx)}, always '{floor_lab}')")
        block_folds = list(contiguous_block_folds(frame_a, N_BLOCKS))

    # -- 3. grid -----------------------------------------------------------
    head("3  RESULTS GRID -- representation x feature set x model")
    grid = OrderedDict()
    sel = {}                                         # the selection metric per cell
    for rep in REPRESENTATIONS:
        fr = frames[rep]
        for fset, feats in FEATURE_SETS.items():
            for kind in MODEL_KINDS:
                key = (rep, fset, kind)
                rnd = random_summary(kind, fr, feats)
                if multi_session:
                    r = evaluate_folds(kind, fr, feats, folds)
                    tb = evaluate(kind, fr, feats, tb_train, tb_test)
                    grid[key] = dict(main=r, tb=tb, rnd=rnd)
                    sel[key] = r["acc"] if "skipped" not in r else float("nan")
                    if "skipped" in r:
                        print(f"  {LETTER[rep]} {fset:4s} {kind:3s}  SKIPPED: {r['skipped']}")
                    else:
                        print(f"  {LETTER[rep]} {fset:4s} {kind:3s}  LOSO {fmt_ci(r)}  folds "
                              + "/".join(f"{f['acc']:.4f}" for f in r["folds"])
                              + (f"  within-session {fmt_ci(tb)}" if "skipped" not in tb
                                 else f"  within-session SKIPPED: {tb['skipped']}")
                              + f"  random {rnd[0]:.4f} [{rnd[1]:.4f}, {rnd[2]:.4f}]"
                              + (f"  ({r['note']})" if r["note"] else "")
                              + (f"  [{r['n_excluded']} stance(s) excluded: non-finite feature]"
                                 if r["n_excluded"] else ""))
                else:
                    r = evaluate(kind, fr, feats, train_idx, test_idx)
                    cv_acc, cv_folds, cv_skip = cv_accuracy(kind, fr, feats, block_folds)
                    grid[key] = dict(main=r, cv=cv_acc, cv_folds=cv_folds, cv_skip=cv_skip, rnd=rnd)
                    sel[key] = cv_acc
                    if "skipped" in r:
                        print(f"  {LETTER[rep]} {fset:4s} {kind:3s}  SKIPPED: {r['skipped']}")
                    else:
                        print(f"  {LETTER[rep]} {fset:4s} {kind:3s}  time-blocked {fmt_ci(r)}  "
                              f"block-CV {cv_acc:.4f}  random {rnd[0]:.4f} [{rnd[1]:.4f}, {rnd[2]:.4f}]"
                              + (f"  ({r['note']})" if r["note"] else ""))

    # -- headline by the pre-registered rule --------------------------------
    order_rep = {"raw": 0, "gain_matched": 1, "conductance": 2}
    order_kind = {"lda": 0, "qda": 1}
    candidates = [k for k in grid if k[1] == "cop" and k[2] in ("lda", "qda")
                  and "skipped" not in grid[k]["main"] and np.isfinite(sel[k])]
    headline = sorted(candidates, key=lambda k: (-round(sel[k], 6), order_rep[k[0]], order_kind[k[2]]))[0]
    h_rep, h_fset, h_kind = headline
    H = grid[headline]["main"]
    h_frame = frames[h_rep]
    h_feats = FEATURE_SETS[h_fset]
    sel_name = ("pooled leave-one-session-out accuracy" if multi_session
                else "contiguous-block CV accuracy")
    print(f"\n  HEADLINE (rule: CoP-only; best {sel_name} among LDA/QDA; ties -> raw, LDA): "
          f"{LETTER[h_rep]} {h_fset} {h_kind}  {metric_name} {fmt_ci(H)}")
    other_kind = "qda" if h_kind == "lda" else "lda"
    O = grid[(h_rep, h_fset, other_kind)]["main"]
    b, c, p_mc = (mcnemar(H["pred"], O["pred"], H["yte"]) if "skipped" not in O else (0, 0, float("nan")))
    guard_r = None
    if not multi_session:
        g_tr, g_te, g_pc = time_blocked_split(frame_a, TRAIN_FRAC, 1)
        guard_r = evaluate(h_kind, h_frame, h_feats, g_tr, g_te)
    full_best = max((k for k in grid if k[1] == "full" and "skipped" not in grid[k]["main"]),
                    key=lambda k: grid[k]["main"]["acc"])

    # -- 4. mechanisms -------------------------------------------------------
    head("4  MECHANISMS")
    errors = []
    for i, (t, q) in enumerate(zip(H["yte"], H["pred"])):
        if t != q:
            row = h_frame.loc[H["test_idx"][i]]
            errors.append(dict(session=row["session"], onset_s=float(row["onset_s"]),
                               start=int(row["start"]), end=int(row["end"]), true=t, pred=q,
                               s4_zero_frac=float(row["s4_zero_frac"]),
                               **{f: float(row[f]) for f in FULL_FEATURES}))
    pairs = OrderedDict()
    for e in errors:
        pairs.setdefault((e["true"], e["pred"]), []).append(e)
    if multi_session:
        ref_idx = h_frame.index.to_numpy()
        ref_name = "class means over all sessions"
    else:
        ref_idx = train_idx
        ref_name = "training means"
    ref_means = {lab: h_frame.loc[ref_idx][h_frame.loc[ref_idx, "label"] == lab][h_feats + ["s4_zero_frac"]].mean()
                 for lab in CLASSES}
    overlap = band_overlap(h_frame, h_feats, ref_idx)
    s4_frac = {lab: float(frame_a.loc[frame_a["label"] == lab, "s4_zero_frac"].mean()) for lab in CLASSES}
    all_s4 = np.concatenate([s["df"]["s4"].to_numpy() for s in sessions])
    substitute = float(np.median(all_s4[all_s4 > 0]))
    s4_eff = s4_zero_effect_mm(sessions, substitute)
    g_eff = gain_effect_mm(sessions, gains, fs)
    spread = ml_spread_mm(sessions)
    # Peak force against onset time. Every such regression this script runs goes
    # into ONE family and is corrected together: three pooled per-class fits and
    # one fit per (class, session). Reporting the pooled fits alone and quoting
    # the smallest p out of them is the multiple-comparisons error this section
    # used to make, so the family is enumerated here and its size is printed.
    trends = {}
    trend_rows = []
    for lab in CLASSES:
        sub = frame_a[frame_a["label"] == lab]
        lr = stats.linregress(sub["onset_s"], sub["peak_counts"])
        trends[lab] = (float(lr.slope), float(lr.intercept), float(lr.rvalue), float(lr.pvalue))
        trend_rows.append(dict(scope="pooled", label=lab, session="both", n=len(sub),
                               slope=float(lr.slope), r=float(lr.rvalue), p=float(lr.pvalue)))
    for lab in CLASSES:
        for ses in spc[lab]:
            sub = frame_a[(frame_a["label"] == lab) & (frame_a["session"] == ses)]
            lr = stats.linregress(sub["onset_s"], sub["peak_counts"])
            trend_rows.append(dict(scope="per session", label=lab, session=ses, n=len(sub),
                                   slope=float(lr.slope), r=float(lr.rvalue), p=float(lr.pvalue)))
    for row, q in zip(trend_rows, holm([r["p"] for r in trend_rows])):
        row["p_holm"] = q
    n_trend_tests = len(trend_rows)
    for lab in CLASSES:
        print(f"  {lab:8s} s4==0 inside stances {s4_frac[lab]:.1%}  s4-zero CoP effect "
              f"{s4_eff[lab][0]:.1f} mm  gain-match CoP effect {g_eff[lab][0]:.2f} mm (mean)  "
              f"ML spread sd {spread[lab]:.2f} mm  peak-vs-onset slope {trends[lab][0]:+.1f} counts/s "
              f"(p={trends[lab][3]:.3f})")

    # sim-trained models on the same stances, under the representation they
    # were fitted on (their meta says which; pre-stage-20 fits were raw). They
    # are inputs, read from the repository's models/, not from --models-dir.
    sim_acc = {}
    for kind in ("lda", "qda"):
        path = os.path.join(str(MODELS), f"model_{kind}.json")
        if os.path.exists(path):
            m = load_model(path)
            m_rep = m["meta"].get("representation", "raw")
            fr = frames[m_rep]
            X = fr[m["meta"]["features"]].to_numpy(float)
            pred = predict(m, X)
            sim_acc[kind] = (float((pred == fr["label"].to_numpy()).mean()),
                             int((pred == fr["label"].to_numpy()).sum()), m_rep)

    # -- figures ---------------------------------------------------------------
    fig_feature_distributions(h_frame, h_feats, os.path.join(args.fig_dir, "feature_distributions.png"))
    fig_peak_vs_onset(frame_a, trends, os.path.join(args.fig_dir, "peak_vs_onset.png"))
    err_figs = {}
    for (t, q), rows in pairs.items():
        name = f"errors_{t}_to_{q}.png"
        fig_errors(sessions, rows, h_rep, gains, fs, os.path.join(args.fig_dir, name),
                   f"true {t} -> predicted {q}: {len(rows)} test stance(s), "
                   f"CoP under {LETTER[h_rep]} ({h_rep}); circle = onset, square = end")
        err_figs[(t, q)] = name

    # -- 5. persist models --------------------------------------------------------
    head("5  PERSIST")
    # Models are persisted under EVERY representation that matters here, each one
    # labelled with its own, because the model file format no longer decides which
    # representation the project may ship. Each JSON records "representation" and
    # insole/infer_live.py reads that field and applies the matching transform,
    # refusing only a model whose representation it cannot honour -- so the
    # pre-registered rule's choice can exist as a loadable model instead of only
    # as a row in a table, and the shipped default is a recorded decision rather
    # than a consequence of what the loader happened to accept.
    #
    # The shipped representation keeps the unsuffixed name (models/model_*_real.json,
    # infer_live's default, run_demo.sh's path); any other gets a _<rep> suffix.
    p_rep = SHIPPED
    P = grid[(p_rep, h_fset, h_kind)]["main"]
    persist_reps = [SHIPPED] + [r for r in (h_rep,) if r != SHIPPED]
    if p_rep != h_rep:
        print(f"  rule's headline representation is {LETTER[h_rep]} ({h_rep}); shipped default stays "
              f"{LETTER[p_rep]} ({p_rep}) by recorded decision: {h_kind} {metric_name} {fmt_ci(P)}")
    print(f"  persisting under {len(persist_reps)} representation(s): "
          + ", ".join(f"{LETTER[r]} ({r})" for r in persist_reps))
    saved = {}                                       # (rep, kind) -> repo-relative path
    n_sess_txt = ", ".join(f"{lab} {len(spc[lab])}" for lab in CLASSES)
    decision = (
        f"Shipped default is {LETTER[SHIPPED]} ({SHIPPED}), frozen at stage 20 on the _02 set and "
        f"left standing at stage 21. On the two-session data the pre-registered rule prefers "
        f"{LETTER[h_rep]} ({h_rep}) by "
        f"{abs(grid[(h_rep, h_fset, h_kind)]['main']['n_correct'] - P['n_correct'])} stance(s) in "
        f"{H['n_test']}, a margin finer than this data can resolve, so the freeze was not "
        f"disturbed. This is a recorded decision, not a constraint of the file format: "
        f"infer_live.py loads whichever representation a model names."
        if h_rep != SHIPPED else
        f"Shipped default is {LETTER[SHIPPED]} ({SHIPPED}); the pre-registered rule picks it again "
        f"on the current data. infer_live.py loads whichever representation a model names.")
    for rep in persist_reps:
        X_all = frames[rep][h_feats].to_numpy(float)
        suffix = "" if rep == SHIPPED else f"_{rep}"
        for kind, fit in (("lda", fit_lda), ("qda", fit_qda)):
            try:
                m = fit(X_all, y_all)
            except (DegenerateClassError, SingularCovarianceError) as e:
                print(f"  {LETTER[rep]} {kind}: not persisted ({e})")
                continue
            g = grid[(rep, h_fset, kind)]
            r = g["main"]
            if "skipped" in r:
                check = {"skipped": r["skipped"]}
            elif multi_session:
                check = {"split": "leave-one-session-out, every stance tested once out of its own session, pooled",
                         "n_test": int(r["n_test"]), "accuracy": float(r["acc"]),
                         "n_correct": int(r["n_correct"]),
                         "wilson95_lo": float(r["lo"]), "wilson95_hi": float(r["hi"]),
                         "wilson95_is_lower_bound_on_uncertainty": True,
                         "wilson95_caveat": (
                             f"The pooled interval treats {int(r['n_test'])} stances from "
                             f"{len(sets)} capture sessions of 1 subject as "
                             f"{int(r['n_test'])} independent observations. Stances within a "
                             "session are positively correlated, so the true interval is WIDER by "
                             "an unknown amount; two sessions cannot estimate the between-session "
                             "variance. Use the per-fold intervals as the honest spread."),
                         "test_floor": float(all_floor),
                         "folds": [{"held_out": f["held_out"], "n_train": int(f["n_train"]),
                                    "n_test": int(f["n_test"]), "accuracy": float(f["acc"]),
                                    "wilson95_lo": float(f["lo"]), "wilson95_hi": float(f["hi"])}
                                   for f in r["folds"]],
                         "within_session_time_blocked_accuracy": (float(g["tb"]["acc"])
                                                                  if "skipped" not in g["tb"] else None),
                         "random_split_mean": float(g["rnd"][0])}
            else:
                check = {"split": "time-blocked within session, NOT per-session",
                         "n_train": int(len(train_idx)), "n_test": int(len(test_idx)),
                         "accuracy": float(r["acc"]), "n_correct": int(r["n_correct"]),
                         "wilson95_lo": float(r["lo"]), "wilson95_hi": float(r["hi"]),
                         "test_floor": float(floor),
                         "block_cv_accuracy": float(g["cv"]),
                         "random_split_mean": float(g["rnd"][0])}
            meta = {
                "purpose": ("classifier trained on the real captures; infer_live.py's default model"
                            if rep == SHIPPED else
                            f"classifier trained on the real captures under representation "
                            f"{LETTER[rep]} ({rep}), the pre-registered rule's headline "
                            f"representation; not the shipped default"),
                "training_data": (f"REAL: data/real, sets {', '.join('_' + s for s in sets)} "
                                  f"(sessions per class: {n_sess_txt}), 60 s per session, one subject, "
                                  "figure-8 path, tethered USB; stances by detector.find_stances + "
                                  "merge_close on raw counts at the committed thresholds"),
                "sessions": sorted(frame_a["session"].unique().tolist()),
                "n_rows": int(n_all),
                "class_counts": {lab: int((y_all == lab).sum()) for lab in CLASSES},
                "representation": rep,
                "representation_letter": LETTER[rep],
                "is_shipped_default": rep == SHIPPED,
                "representation_decision": decision,
                "gain_match": os.path.relpath(args.gain, REPO) if rep == "gain_matched" else None,
                "headline_cell": f"{LETTER[h_rep]} {h_fset} {h_kind}",
                "headline_accuracy": float(H["acc"]),
                "feature_set": h_fset,
                "features": h_feats,
                "split": split_name + ("" if multi_session else " -- NOT a per-session split"),
                "heldout_check": check,
                "geometry": {"insole_len_mm": D.INSOLE_LEN_MM, "insole_width_mm": D.INSOLE_WIDTH_MM,
                             "sensor_mm": {k: list(v) for k, v in D.SENSOR_MM.items()}},
                "detector": {"T_ON": D.T_ON, "T_OFF": D.T_OFF, "MIN_DURATION": D.MIN_DURATION,
                             "MAX_DURATION": D.MAX_DURATION, "GAP_MERGE": D.GAP_MERGE},
                "git_hash": git_hash(),
                "fit_script": "scripts/train_real.py",
            }
            path = os.path.join(args.models_dir, f"model_{kind}_real{suffix}.json")
            save_model(m, path, meta=meta)
            saved[(rep, kind)] = os.path.relpath(path, REPO)
            print(f"  wrote {saved[(rep, kind)]}  ({LETTER[rep]} {rep}"
                  + (", shipped default" if rep == SHIPPED else "") + ")")

    # -- 6. the document ------------------------------------------------------------
    head("6  DOCUMENT -> " + os.path.relpath(args.doc, REPO))
    L = LETTER
    out("# Real-data results")
    out()
    out("Every number in this file is produced by `python scripts/train_real.py`; "
        "regenerate it, do not edit it (the persisted models' meta records the git hash of "
        "the run). Figures: "
        f"`{os.path.relpath(args.fig_dir, REPO)}/`. Models: "
        + ", ".join(f"`{p}`" for p in saved.values()) + ".")
    out()
    out("## 1. Data")
    out()
    out(f"Every training-grade capture in `data/real/` (`data/real/README.md`): "
        f"{len(sets)} set{'s' if len(sets) != 1 else ''} ({', '.join('`_' + s + '`' for s in sets)}), "
        "one 60 s session per activity in each, 100 Hz, tethered USB, one subject, walking a "
        "figure-8. `_01` is failure evidence and is never trained or evaluated on. Segmentation "
        "uses `insole/detector.py` at the committed thresholds "
        f"(T_ON={D.T_ON}, T_OFF={D.T_OFF}, MIN_DURATION={D.MIN_DURATION}, "
        f"MAX_DURATION={D.MAX_DURATION}, GAP_MERGE={D.GAP_MERGE}) on raw counts, and every file's "
        "stance count is pinned twice, in `SESSIONS` here and in `tests/test_stances.py`:")
    out()
    out("| activity | file | frames | stances kept |")
    out("|---|---|---|---|")
    for s in sessions:
        out(f"| {s['label']} | `{s['file']}` | {len(s['df'])} | {len(s['stances'])} |")
    out()
    per_sess = ", ".join(f"{lab} " + " + ".join(
        str(int(((frame_a['label'] == lab) & (frame_a['session'] == ses)).sum())) for ses in spc[lab])
        for lab in CLASSES)
    out("Each standing capture is one unbroken contact the length of the file, rejected by "
        f"MAX_DURATION, so it contributes no stances and is excluded from classification. n = {n_all} "
        f"moving stances ({', '.join(f'{lab} {int((y_all == lab).sum())}' for lab in CLASSES)}; per "
        f"session {per_sess}); the all-data majority floor is {all_floor:.4f} ({all_floor_n}/{n_all}, "
        f"`{all_floor_lab}`).")
    out()
    out("## 2. Representations and feature sets")
    out()
    out("Features are `insole/features.py`'s extractors, unchanged, computed on three per-frame "
        "input representations (`insole/representations.py`); the detector always runs on raw counts:")
    out()
    out("- **A raw**: the six ADC counts as logged.")
    out("- **B conductance**: x = counts / (4095 − counts) per channel; x(0) = 0.")
    out(f"- **C gain-matched**: x · g, g from `models/gain_match.json` "
        f"({', '.join(f's{i}={gains[i]:.4f}' for i in range(6))}).")
    out()
    out("Force is linear in conductance (`insole/calibration.py`), so under B and C the centre of "
        "pressure is a force-proportional centroid and under A it is not. The gain match is a "
        "single-point relative match at ~12 N: above 824 counts (62–67 % of loaded walking "
        "frames of the `_02` set, `scripts/analyze_real.py` C3) it extrapolates, and below ~5 N "
        "the channels' activation thresholds differ, so it does not hold there.")
    out()
    best_by_rep = {rep: max(sel[(rep, "cop", k)] for k in ("lda", "qda")) for rep in REPRESENTATIONS}
    rule_txt = (f"{sel_name}, CoP-only, best of LDA/QDA: A {best_by_rep['raw']:.4f}, "
                f"B {best_by_rep['conductance']:.4f}, C {best_by_rep['gain_matched']:.4f}")
    if h_rep == SHIPPED:
        verdict = f"On the current data the rule picks {L[SHIPPED]} again ({rule_txt})."
    else:
        hn = grid[(h_rep, "cop", h_kind)]["main"]
        pn = grid[(SHIPPED, "cop", h_kind)]["main"]
        d = abs(hn["n_correct"] - pn["n_correct"])
        oh, op = overlap_fraction((hn["lo"], hn["hi"]), (pn["lo"], pn["hi"]))
        verdict = (
            f"On the current data the rule prefers {L[h_rep]} ({h_rep}) over {L[SHIPPED]} "
            f"({SHIPPED}) by {d} stance(s) in {H['n_test']} -- {d / H['n_test']:.1%} -- "
            f"({rule_txt}). **The rule's deciding margin is finer than the resolution of the data "
            f"it is deciding on.** One stance either way is {1 / H['n_test']:.1%} of the test set, "
            f"so the whole decision rests on {d} stance{'s' if d != 1 else ''}; the two cells' "
            f"Wilson intervals, [{hn['lo']:.4f}, {hn['hi']:.4f}] for {L[h_rep]} and "
            f"[{pn['lo']:.4f}, {pn['hi']:.4f}] for {L[SHIPPED]}, overlap over {min(oh, op):.0%} of "
            f"their length; and those intervals are themselves lower bounds on the uncertainty "
            f"(section 3). **{L[h_rep]} and {L[SHIPPED]} are statistically indistinguishable on "
            f"this data**, and which of them the rule ranks first at this sample size is arbitrary. "
            f"**{L[SHIPPED]} remains the shipped representation and is FROZEN -- retained as a "
            f"pre-existing freeze taken at stage 20 on the `_02` set, not as this rule's verdict.** "
            f"The rule did not choose {L[SHIPPED]} here. It chose {L[h_rep]}, by a margin that "
            f"means nothing, and the existing freeze was left standing because switching the "
            f"shipped representation moves the sim bake-off frame, the sim-trained models and the "
            f"streaming path together -- for a change this data cannot show to be an improvement. "
            f"Any statement that the rule selected {L[SHIPPED]} is wrong. Both numbers are in "
            f"section 4, and real models are now persisted under both representations, each "
            f"labelled with its own (section 5).")
    out(f"**Shipped representation: {L[SHIPPED]} ({SHIPPED})** -- `insole.representations.SHIPPED`, "
        f"the one `insole/infer_live.py` feeds on every source, `scripts/bakeoff.py` builds the sim "
        f"frame under, and the persisted models are fitted on. It was chosen at stage 20 by the "
        f"headline rule in section 4 on the `_02` set. {verdict} The simulator has no per-channel "
        "gain to correct, so under B every source is treated identically; the gain match still runs "
        "per frame for the extrapolation counter and never reaches the classifier (variant B, not C).")
    out()
    out("Two feature sets: **cop** = `cop_path_len`, `cop_displacement` (exactly the set "
        "`scripts/bakeoff.py` used, for comparability with the simulator), and **full** = all "
        "seven (`peak_counts`, `time_to_peak_s`, `contact_time_s`, `loading_rate_cps`, "
        "`impulse_counts_s` plus the two CoP features). The sim bake-off excluded the five "
        "timing/magnitude features because simulated fast and walk differ only in cadence, so "
        "any cadence feature reads the label off the generator. On real data cadence is measured, "
        "not constructed, so the full set is a legitimate classifier here, but it is not "
        "comparable with the sim number. Under B and C the count-valued features are in "
        "conductance units and keep their column names.")
    out()
    out("## 3. Split")
    out()
    if multi_session:
        out(f"**{split_name}.** Every class has at least two sessions, so the script switched "
            "itself to leave-one-session-out: fold k holds out session k of every class and trains "
            "on the rest, so every stance is tested exactly once, out of its own session, and the "
            "headline pools the folds' predictions. Nothing in a test fold shares a session with "
            "anything in its training fold. It is still one subject, the same shoe, the same "
            "figure-8 path, and two sessions is the minimum that makes this split possible, not a "
            "comfortable margin: with two folds one odd session moves the number a lot.")
        out()
        out("| fold | held out | " + " | ".join(f"{lab} train / test" for lab in CLASSES) + " | n_train | n_test |")
        out("|---|---|" + "---|" * (len(CLASSES) + 2))
        for k, (held, pc, ntr, nte) in enumerate(fold_pc):
            out(f"| {k} | {', '.join(f'`{h}`' for h in held)} | "
                + " | ".join(f"{pc[lab][0]} / {pc[lab][1]}" for lab in CLASSES)
                + f" | {ntr} | {nte} |")
        out()
        out(f"Pooled n_test = {n_all} (every stance once), majority floor = {all_floor:.4f} "
            f"({all_floor_n}/{n_all}, always `{all_floor_lab}`).")
        out()
        out(ci_caveat(n_all, len(sets)))
        out()
        out(f"Reported beside it so the within-session optimism is visible: the **{tb_name}**, "
            "pooled over sessions (" + ", ".join(
                f"{lab} {tb_per_class[lab][0]}/{tb_per_class[lab][1]}" for lab in CLASSES)
            + "), which was the headline recipe while there was one session per class and "
            "carries the leakage that implies (consecutive stances of one walk share the day, the "
            "sensor state and the path); and a **random stance-level split** with the same "
            f"per-class sizes, {N_RANDOM} seeds (mean, min, max), which puts near-copies of every "
            "test stance into training and is expected to be the most optimistic of the three.")
    else:
        out(f"**{split_name}.** There is one session per class, so no per-session split exists. "
            "Stances are sorted by onset within each session; the earlier ones train and the later "
            "ones test. This is a within-session number and carries the leakage that implies: "
            "consecutive stances of one walk share the subject, the day, the shoe, the path and the "
            "sensor state. Do not read it as generalisation to a new session.")
        out()
        out("| class | train | test | dropped (guard) |")
        out("|---|---|---|---|")
        for lab in CLASSES:
            out(f"| {lab} | {per_class[lab][0]} | {per_class[lab][1]} | {per_class[lab][2]} |")
        out()
        out(f"n_train = {len(train_idx)}, n_test = {len(test_idx)}, test majority floor = {floor:.4f} "
            f"({floor_n}/{len(test_idx)}, always `{floor_lab}`).")
        out()
        out("Two further splits are reported beside it so the optimism gap is visible: a **random "
            f"stance-level split** with the same per-class sizes, {N_RANDOM} seeds (mean, min, max), which "
            "puts near-copies of every test stance into training and is expected to be optimistic; and "
            f"**contiguous-block cross-validation**, {N_BLOCKS} time blocks per class, each block held out "
            "once, which tests every stance exactly once with its own block out of training.")
    out()
    out("## 4. Results grid")
    out()
    if multi_session:
        out("Pooled leave-one-session-out accuracy with a Wilson 95 % interval and the count, then "
            "each fold's accuracy (fold order as in section 3), then the within-session time-blocked "
            "accuracy with its interval, then the random-split mean [min, max]. LDA/QDA are "
            "`insole/discriminant.py`; LR is sklearn's `LogisticRegression` on standardised features, as "
            "in `scripts/bakeoff.py`. A skipped cell says why.")
        out()
        out("| rep | features | model | leave-one-session-out acc [Wilson 95 %] | per fold | within-session time-blocked | random split |")
        out("|---|---|---|---|---|---|---|")
        for key, g in grid.items():
            rep, fset, kind = key
            r = g["main"]
            star = " **(headline)**" if key == headline else ""
            if "skipped" in r:
                out(f"| {L[rep]} | {fset} | {kind} | skipped: {r['skipped']} | | | |")
            else:
                tb = g["tb"]
                out(f"| {L[rep]} | {fset} | {kind} | {fmt_ci(r)}{star} | "
                    + " / ".join(f"{f['acc']:.4f}" for f in r["folds"]) + " | "
                    + (fmt_ci(tb) if "skipped" not in tb else f"skipped: {tb['skipped']}") + " | "
                    f"{g['rnd'][0]:.4f} [{g['rnd'][1]:.4f}, {g['rnd'][2]:.4f}] |")
    else:
        out("Accuracy on the time-blocked test set with a Wilson 95 % interval and the count, then the "
            "block-CV pooled accuracy, then the random-split mean [min, max]. LDA/QDA are "
            "`insole/discriminant.py`; LR is sklearn's `LogisticRegression` on standardised features, as "
            "in `scripts/bakeoff.py`. A skipped cell says why.")
        out()
        out("| rep | features | model | time-blocked acc [Wilson 95 %] | block-CV | random split |")
        out("|---|---|---|---|---|---|")
        for key, g in grid.items():
            rep, fset, kind = key
            r = g["main"]
            star = " **(headline)**" if key == headline else ""
            if "skipped" in r:
                out(f"| {L[rep]} | {fset} | {kind} | skipped: {r['skipped']} | | |")
            else:
                out(f"| {L[rep]} | {fset} | {kind} | {fmt_ci(r)}{star} | {g['cv']:.4f} | "
                    f"{g['rnd'][0]:.4f} [{g['rnd'][1]:.4f}, {g['rnd'][2]:.4f}] |")
    nonfinite = frame_a.loc[~np.isfinite(frame_a[FULL_FEATURES].to_numpy(float)).all(axis=1)]
    if len(nonfinite):
        out()
        out(f"\"excl.\" counts stances left out of that cell because a feature is not finite: "
            + "; ".join(f"`{r['session']}` stance at frame {int(r['start'])} "
                        f"({', '.join(f for f in FULL_FEATURES if not np.isfinite(r[f]))})"
                        for _, r in nonfinite.iterrows())
            + ". `loading_rate_cps` is undefined when the peak is the first frame of the stance, "
            "which a capture that starts mid-contact produces; the stance stays in every cell whose "
            "features are finite.")
    out()
    out("### Headline")
    out()
    if multi_session:
        out(f"Rule, fixed before any result was seen: CoP-only features; among LDA and QDA under A, B "
            f"and C, the cell with the best {sel_name}; ties go to raw counts and to LDA. "
            f"That is **{L[h_rep]} ({h_rep}), {h_fset}, {h_kind.upper()}**: leave-one-session-out "
            f"accuracy **{H['acc']:.4f}** [{H['lo']:.4f}, {H['hi']:.4f}] ({H['n_correct']}/{H['n_test']}) "
            f"against a majority floor of {all_floor:.4f}; per fold "
            + ", ".join(f"{f['acc']:.4f} [{f['lo']:.4f}, {f['hi']:.4f}] ({f['n_correct']}/{f['n_test']}) "
                        f"holding out {', '.join(f'`{h}`' for h in f['held_out'])}" for f in H["folds"])
            + f"; within-session time-blocked {fmt_ci(grid[headline]['tb'])}; random split "
            f"{grid[headline]['rnd'][0]:.4f} [{grid[headline]['rnd'][1]:.4f}, {grid[headline]['rnd'][2]:.4f}]. "
            "The selection metric and the reported metric are the same number here, picked among six "
            "cells, so the headline carries that much selection optimism. The gap between the "
            "within-session number and the leave-one-session-out number is what a session boundary "
            f"costs on this data: {grid[headline]['tb']['acc'] - H['acc']:+.4f}.")
        out()
        out(ci_caveat(H["n_test"], len(sets)))
    else:
        out(f"Rule, fixed before any result was seen: CoP-only features; among LDA and QDA under A, B "
            f"and C, the cell with the best block-CV accuracy; ties go to raw counts and to LDA. "
            f"That is **{L[h_rep]} ({h_rep}), {h_fset}, {h_kind.upper()}**: time-blocked accuracy "
            f"**{H['acc']:.4f}** [{H['lo']:.4f}, {H['hi']:.4f}] ({H['n_correct']}/{H['n_test']}) against a "
            f"test floor of {floor:.4f}; block-CV {grid[headline]['cv']:.4f} "
            f"(folds {', '.join(f'{a:.3f}' for a in grid[headline]['cv_folds'])}); random split "
            f"{grid[headline]['rnd'][0]:.4f} [{grid[headline]['rnd'][1]:.4f}, {grid[headline]['rnd'][2]:.4f}]. "
            f"The gap between the random-split mean and the time-blocked number is the optimism that "
            f"temporal adjacency buys on this data: {grid[headline]['rnd'][0] - H['acc']:+.4f}.")
    out()
    if p_rep != h_rep:
        out(f"**Both representations are persisted, each labelled with its own.** "
            f"`models/model_{{lda,qda}}_real.json` are fitted under **{L[p_rep]} ({p_rep})**, the "
            f"shipped default; `models/model_{{lda,qda}}_real_{h_rep}.json` under **{L[h_rep]} "
            f"({h_rep})**, the rule's headline representation. Every model JSON records a "
            f"`representation` field and `insole/infer_live.py` reads it and applies the matching "
            f"transform, refusing only a model whose representation it cannot honour (an absent "
            f"field, an unknown name, or {L['gain_matched']} with `--gain none`) -- there is no "
            f"silent fallback. **The shipped default is therefore a recorded decision, not a "
            f"consequence of what the loader would accept.** Under {L[p_rep]} the headline cell "
            f"scores {fmt_ci(P)}, {abs(H['n_correct'] - P['n_correct'])} stance(s) apart from the "
            f"{L[h_rep]} headline; that is the deployed model's number, and the two are "
            f"indistinguishable on this data (section 2).")
        out()
    if guard_r is not None and "skipped" not in guard_r:
        out(f"With a one-stance guard band between the training and test blocks (training loses its "
            f"last stance per class) the same cell scores {fmt_ci(guard_r)}.")
        out()
    fb = grid[full_best]
    out(f"The best full-feature cell is {L[full_best[0]]} {full_best[1]} {full_best[2]} at "
        f"{fmt_ci(fb['main'])}"
        + (f" (within-session {fmt_ci(fb['tb'])})" if multi_session and "skipped" not in fb["tb"]
           else (f" (block-CV {fb['cv']:.4f})" if not multi_session else ""))
        + ". It is the better classifier of these activities and it is reported here as such, but "
        "it rides on `contact_time_s` and its relatives, whose class medians on this data are "
        + ", ".join(f"{lab} {frame_a.loc[frame_a['label'] == lab, 'contact_time_s'].median():.2f} s" for lab in CLASSES)
        + ", i.e. on cadence; it is not comparable with the sim bake-off and does not test the CoP features.")
    out()
    out(denominators(H, fb["main"], frame_a))
    out()
    out("Confusion matrix of the headline cell (rows true, columns predicted, order "
        + ", ".join(CLASSES) + ")" + (", pooled over the folds" if multi_session else "") + ":")
    out()
    out("| | " + " | ".join(CLASSES) + " | recall |")
    out("|---|" + "---|" * (len(CLASSES) + 1))
    for i, lab in enumerate(CLASSES):
        out(f"| **{lab}** | " + " | ".join(str(v) for v in H["conf"][i]) + f" | {H['recall'][lab]:.3f} |")
    out("| precision | " + " | ".join(f"{H['precision'][lab]:.3f}" for lab in CLASSES) + " | |")
    out()
    worst = min(CLASSES, key=lambda lab: H["recall"][lab])
    wi = CLASSES.index(worst)
    wq = CLASSES[int(np.argmax([v if j != wi else -1 for j, v in enumerate(H["conf"][wi])]))]
    out(f"Per-class recall " + ", ".join(f"{lab} {H['recall'][lab]:.3f}" for lab in CLASSES)
        + f": {worst} test stances are called {wq} {H['conf'][wi][CLASSES.index(wq)]} times out of "
        f"{sum(H['conf'][wi])}. "
        + ("The table below shows why a session boundary does that -- the two sessions of one class "
           "are not the same distribution:" if multi_session else
           "The table below shows why a time-blocked split does that -- the training block and the "
           "test block of one session are not the same distribution:"))
    out()
    if multi_session:
        out("| feature | class | session | n | mean | sd | shift from the class's other session(s), in pooled sd |")
        out("|---|---|---|---|---|---|---|")
        for f in h_feats:
            for lab in CLASSES:
                cls = h_frame[h_frame["label"] == lab]
                pooled_sd = cls[f].std()
                for ses in spc[lab]:
                    v = cls.loc[cls["session"] == ses, f]
                    o = cls.loc[cls["session"] != ses, f]
                    shift = (v.mean() - o.mean()) / pooled_sd if pooled_sd > 0 and len(o) else float("nan")
                    out(f"| {f} | {lab} | `{ses}` | {len(v)} | {v.mean():.4f} | {v.std():.4f} | {shift:+.2f} |")
    else:
        out("| feature | class | train block mean | test block mean | shift in test-block sd |")
        out("|---|---|---|---|---|")
        for f in h_feats:
            for lab in CLASSES:
                tr_v = h_frame.loc[train_idx][h_frame.loc[train_idx, "label"] == lab][f]
                te_v = h_frame.loc[test_idx][h_frame.loc[test_idx, "label"] == lab][f]
                sd = te_v.std() if len(te_v) > 1 and te_v.std() > 0 else float("nan")
                out(f"| {f} | {lab} | {tr_v.mean():.4f} | {te_v.mean():.4f} | {(te_v.mean() - tr_v.mean()) / sd:+.2f} |")
    out()
    if "skipped" not in O:
        out(f"McNemar, {h_kind.upper()} vs {other_kind.upper()} on the same test stances: b = {b}, c = {c}"
            + (f", exact two-sided p = {p_mc:.4f}" if b + c else " -- no discordant pairs, no test")
            + (f"; the smallest p attainable at b + c = {b + c} is {min(1.0, 2 * 0.5 ** (b + c)):.4f}."
               if b + c else "."))
        out()
    out("## 5. Per-class feature distributions (headline cell)")
    out()
    out(f"![feature distributions]({os.path.relpath(os.path.join(args.fig_dir, 'feature_distributions.png'), os.path.dirname(args.doc))})")
    out()
    out("| feature | class | n | mean | sd | min | median | max |")
    out("|---|---|---|---|---|---|---|---|")
    for f in h_feats:
        for lab in CLASSES:
            v = h_frame.loc[h_frame["label"] == lab, f]
            out(f"| {f} | {lab} | {len(v)} | {v.mean():.4f} | {v.std():.4f} | {v.min():.4f} | {v.median():.4f} | {v.max():.4f} |")
    out()
    out("Fraction of each class's stances (all of them) that fall inside another class's "
        f"p10–p90 band ({'all sessions' if multi_session else 'training block'}), per feature. "
        "High values are the overlap the classifier cannot resolve:")
    out()
    out("| feature | class | inside " + " band | inside ".join(CLASSES) + " band |")
    out("|---|---|" + "---|" * len(CLASSES))
    for f in h_feats:
        for a in CLASSES:
            cells = ["—" if a == b_ else f"{overlap[(f, a, b_)]:.2f}" for b_ in CLASSES]
            out(f"| {f} | {a} | " + " | ".join(cells) + " |")
    out()
    out("## 6. Every misclassified test stance")
    out()
    if multi_session:
        out("Every stance was tested once, out of its own session, so this is every stance the headline "
            "cell gets wrong anywhere in the data.")
        out()
    if not errors:
        out("None.")
    else:
        out("| session | onset (s) | true | predicted | " + " | ".join(h_feats) + " | contact_time_s | s4 = 0 frames |")
        out("|---|---|---|---|" + "---|" * (len(h_feats) + 2))
        for e in errors:
            out(f"| {e['session']} | {e['onset_s']:.2f} | {e['true']} | {e['pred']} | "
                + " | ".join(f"{e[f]:.4f}" for f in h_feats)
                + f" | {e['contact_time_s']:.2f} | {e['s4_zero_frac']:.0%} |")
        out()
        for (t, q), rows in pairs.items():
            out(f"### {t} → {q} ({len(rows)})")
            out()
            out(f"![{t} to {q}]({os.path.relpath(os.path.join(args.fig_dir, err_figs[(t, q)]), os.path.dirname(args.doc))})")
            out()
            sent = []
            for f in h_feats:
                em = float(np.mean([r[f] for r in rows]))
                mt, mq = float(ref_means[t][f]), float(ref_means[q][f])
                nearer = q if abs(em - mq) < abs(em - mt) else t
                sent.append(f"`{f}` averages {em:.4f} over these stances against {ref_name} "
                            f"{mt:.4f} ({t}) and {mq:.4f} ({q}), nearer to {nearer}")
            s4m = float(np.mean([r["s4_zero_frac"] for r in rows]))
            sent.append(f"s4 read 0 on {s4m:.0%} of their frames against {float(ref_means[t]['s4_zero_frac']):.0%} "
                        f"for {t} and {float(ref_means[q]['s4_zero_frac']):.0%} for {q} ({ref_name}); on those frames "
                        f"the CoP is a five-sensor centroid, and the counterfactual below puts that at "
                        f"{s4_eff[t][0]:.1f} mm for {t}")
            ct = float(np.mean([r["contact_time_s"] for r in rows]))
            sent.append(f"their contact time averages {ct:.2f} s against class medians "
                        f"{frame_a.loc[frame_a['label'] == t, 'contact_time_s'].median():.2f} s ({t}) and "
                        f"{frame_a.loc[frame_a['label'] == q, 'contact_time_s'].median():.2f} s ({q}), which the "
                        f"CoP-only cell never sees")
            out("Measured: " + "; ".join(sent) + ".")
            out()
    out("## 7. Mechanisms, measured")
    out()
    out("| class | s4 = 0 inside stances | CoP shift on s4-zero frames (mm) | CoP shift A → C, all stance frames (mean / median mm) | stance-to-stance ML spread sd (mm) |")
    out("|---|---|---|---|---|")
    for lab in CLASSES:
        out(f"| {lab} | {s4_frac[lab]:.1%} | {s4_eff[lab][0]:.1f} | {g_eff[lab][0]:.2f} / {g_eff[lab][1]:.2f} | {spread[lab]:.2f} |")
    out()
    out(f"**s4 zeros.** s4 (1st metatarsal head) has the highest activation threshold of the six, so "
        f"its zeros are below-threshold readings, never imputed. On the frames inside kept stances "
        f"it reads 0 on {s4_frac['fast']:.0%} (fast), {s4_frac['walk']:.0%} (walk) and "
        f"{s4_frac['shuffle']:.0%} (shuffle) of frames. The CoP shift those zeros are responsible "
        f"for is measured directly: on every such frame the CoP is recomputed with s4 set to the "
        f"median non-zero s4 count across the captures ({substitute:.0f} counts) and the "
        f"difference taken -- {s4_eff['fast'][0]:.1f} / {s4_eff['walk'][0]:.1f} / {s4_eff['shuffle'][0]:.1f} mm "
        f"for fast / walk / shuffle, on a 91 mm wide insole.")
    out()
    accs = {r: grid[(r, "cop", h_kind)]["main"]["acc"] for r in REPRESENTATIONS}
    if multi_session:
        beside = "within-session " + " / ".join(
            f"{grid[(r, 'cop', h_kind)]['tb']['acc']:.4f}" for r in REPRESENTATIONS)
    else:
        beside = "block-CV " + " / ".join(f"{sel[(r, 'cop', h_kind)]:.4f}" for r in REPRESENTATIONS)
    out(f"**Gain match.** Replacing raw counts by gain-matched conductance moves the per-frame CoP by "
        f"{g_eff['fast'][0]:.2f} / {g_eff['walk'][0]:.2f} / {g_eff['shuffle'][0]:.2f} mm on average "
        f"(fast / walk / shuffle), i.e. the s4-zero effect is "
        f"{s4_eff['walk'][0] / g_eff['walk'][0]:.0f}× the gain-match effect on walk. The CoP-only "
        f"{h_kind.upper()} scores {accs['raw']:.4f} under A, {accs['conductance']:.4f} under B and "
        f"{accs['gain_matched']:.4f} under C on the {metric_name} split ({beside}): the representation "
        f"moves the answer by at most "
        f"{max(abs(accs[r] - accs['raw']) for r in REPRESENTATIONS) * H['n_test']:.0f} "
        f"test stance(s) in {H['n_test']}. Whatever the representation, the same frames carry the same s4 "
        f"zeros and the same extrapolation above 824 counts.")
    out()
    out(f"**Figure-8 turning.** The stance-to-stance spread of the mean medial-lateral CoP position is "
        f"{spread['walk']:.2f} / {spread['fast']:.2f} / {spread['shuffle']:.2f} mm (sd; walk / fast / shuffle). "
        f"Against the ±15 mm uncertainty on the sensor coordinates this is not resolvable, so turning "
        f"remains a hypothesis, as `docs/sim_vs_real.md` D4b concluded.")
    out()
    out("## 8. Peak force against onset time")
    out()
    out(f"![peak vs onset]({os.path.relpath(os.path.join(args.fig_dir, 'peak_vs_onset.png'), os.path.dirname(args.doc))})")
    out()
    out(f"**{n_trend_tests} tests, corrected together.** Peak total force is regressed on stance "
        f"onset time once per class pooled over that class's sessions ({len(CLASSES)} tests) and "
        f"once per (class, session) ({n_trend_tests - len(CLASSES)} tests) -- "
        f"{n_trend_tests} in all, every one of them run and every one of them looked at. That is "
        "the family, so it is corrected as a family: reporting these fits and then quoting the "
        "smallest p out of them without a correction is exactly the multiple-comparisons error, "
        "and the uncorrected p values below mean nothing on their own. The correction is "
        "Holm-Bonferroni, which controls the family-wise error rate under arbitrary dependence "
        "between the tests -- necessary here, because the pooled fits and the per-session fits are "
        "fitted on overlapping stances and are not independent.")
    out()
    out("| scope | class | session | n | slope (raw counts per s of capture) | r | p | p (Holm, "
        f"m = {n_trend_tests}) |")
    out("|---|---|---|---|---|---|---|---|")
    for r in trend_rows:
        out(f"| {r['scope']} | {r['label']} | `{r['session']}` | {r['n']} | {r['slope']:+.2f} | "
            f"{r['r']:+.3f} | {r['p']:.4f} | {r['p_holm']:.4f} |")
    out()
    if multi_session:
        out("Onset time is seconds into each session's own capture, so the sessions of one class "
            "overlay on the x axis of the figure and of the pooled fits. Stress relaxation acts "
            "within one continuous capture, so the per-session fits are the physically direct test "
            "and the pooled ones mix two captures; both are reported because both were run.")
        out()
    nominal = [r for r in trend_rows if r["p"] < 0.05]
    survivors = [r for r in trend_rows if r["p_holm"] < 0.05]
    rises = [r for r in nominal if r["slope"] > 0]
    falls = [r for r in nominal if r["slope"] < 0]

    def name(r):
        return (f"{r['label']} pooled" if r["scope"] == "pooled" else f"{r['label']} `{r['session']}`")

    if not nominal:
        out(f"No fit reaches p < 0.05 even uncorrected, so nothing here survives correction over "
            f"{n_trend_tests} tests. Peak force shows no detectable trend across a 60 s capture in "
            "either direction.")
    else:
        out("Uncorrected, "
            + "; ".join(f"{name(r)} {'rises' if r['slope'] > 0 else 'falls'} at "
                        f"{r['slope']:+.2f} counts/s (p = {r['p']:.4f}, Holm p = {r['p_holm']:.4f})"
                        for r in nominal)
            + ". "
            + (f"After correction over the {n_trend_tests} tests, **none of them survives at "
               f"p < 0.05** -- the smallest adjusted p in the whole family is "
               f"{min(r['p_holm'] for r in trend_rows):.4f}"
               if not survivors else
               f"After correction over the {n_trend_tests} tests, "
               + ", ".join(f"{name(r)} survives at Holm p = {r['p_holm']:.4f}" for r in survivors))
            + ".")
    out()
    if falls:
        out("**The direction FSR stress relaxation predicts.** A decline over a capture is what "
            "`docs/calibration_notes.md` measured on the bench: counts fall ~31 % in 76 s under "
            "constant load, recovering with a ~20 min time constant. "
            + ("It is not significant here after correction, so this data neither confirms nor "
               "contradicts that finding."
               if not [r for r in falls if r["p_holm"] < 0.05] else
               "It survives correction here, which is consistent with that finding, though "
               "relaxation and a subject slowing down cannot be separated by these captures."))
        out()
    if rises:
        out(f"**A rise runs opposite to the project's best-established physical finding, so it does "
            f"not get reported flatly.** {', '.join(name(r) for r in rises)} "
            f"{'rise' if len(rises) > 1 else 'rises'} rather than falls. FSR stress relaxation is "
            "measured, reproduced across two independent bench sessions, and monotone in rest "
            "interval (`docs/calibration_notes.md`); it predicts peak counts *falling* across a "
            "capture at constant applied force. An apparent contradiction of it needs more than "
            "one uncorrected p value. Two explanations fit the observation and this data does not "
            "separate them:")
        out()
        out("1. **The subject accelerated across the session.** Applied force is not constant in "
            "gait -- the subject can push harder as the capture goes on, and a rising applied "
            "force can outrun a falling sensitivity. Nothing was recorded that would measure "
            "applied force independently of the sensor whose drift is in question, so this "
            "explanation cannot be checked against the captures that produced it.")
        n_pos = sum(1 for r in trend_rows if r["slope"] > 0)
        out(f"2. **A multiple-comparisons artifact.** {n_trend_tests} tests were run; "
            f"{n_pos} of the {n_trend_tests} fitted slopes are positive and "
            f"{n_trend_tests - n_pos} negative, which is what noise around zero looks like. "
            + (f"After Holm correction nothing in the family reaches p < 0.05 "
               f"(smallest adjusted p {min(r['p_holm'] for r in trend_rows):.4f}), so the "
               "correction is sufficient on its own to account for the rise."
               if not survivors else
               "Some tests survive correction, so this explanation does not cover all of them."))
        out()
        out("**Verdict.** "
            + ("The corrected p values kill the result. After Holm correction over the "
               f"{n_trend_tests} tests in the family, no peak-force trend in this data is "
               "significant at p < 0.05 in either direction, the rise included. It is reported "
               "here as a measurement that did not reach significance, not as a finding, and it is "
               "not evidence against stress relaxation. Separating a real acceleration from noise "
               "needs an independent measure of applied force during gait, which this hardware "
               "does not have. **Hardware-blocked.**"
               if not survivors else
               "At least one trend survives correction; see the table for which, and treat the "
               "two explanations above as unresolved."))
    elif nominal and not rises:
        out("**Verdict.** "
            + ("Nothing survives correction; no peak-force trend in this data is significant at "
               "p < 0.05." if not survivors else
               "See the table for what survives correction."))
    else:
        out("**Verdict.** No peak-force trend in this data is significant at p < 0.05, before or "
            "after correction. That is not evidence against FSR stress relaxation -- the bench "
            "measurement was under constant load, and gait loads each sensor for a fraction of a "
            "second at a time -- it says the drift does not visibly enter one minute of walking.")
    out()
    out("## 9. Simulator versus real")
    out()
    if sim_acc:
        out("The sim-trained deployment models (`models/model_lda.json`, `models/model_qda.json`, "
            "fitted on 12 simulated sessions by `scripts/fit_model.py`) applied to the same "
            f"{n_all} real stances under the representation they were fitted on "
            f"({L[sim_acc['lda'][2]]}): LDA {sim_acc['lda'][0]:.4f} "
            f"({sim_acc['lda'][1]}/{n_all}), QDA {sim_acc['qda'][0]:.4f} ({sim_acc['qda'][1]}/{n_all}), "
            f"below the {all_floor:.4f} majority floor -- the expected outcome for a model fitted on a "
            f"generator whose constants were co-evolved with the detector. The same recipe retrained "
            f"on real stances scores {H['acc']:.4f} [{H['lo']:.4f}, {H['hi']:.4f}] {metric_name} "
            f"(the shipped {L[p_rep]} model {P['acc']:.4f} [{P['lo']:.4f}, {P['hi']:.4f}]), "
            f"and the sim bake-off's {0.9296:.4f} on 270 held-out simulated stances "
            f"(`docs/bakeoff.md`) is not a number this data can reproduce or refute: different "
            f"stances, different split, different world.")
    else:
        out("The sim-trained models were not found in the models directory; nothing to compare.")
    out()
    out("## 10. Split verdict: what more data fixes, what the hardware cannot")
    out()
    out("More data would fix:")
    out()
    if multi_session:
        out(f"- **Sessions.** {', '.join(f'{lab} {len(spc[lab])}' for lab in CLASSES)} sessions per "
            "class is the minimum that makes leave-one-session-out possible; every headline interval "
            "here is wide and one odd session moves it a lot. More sessions narrow it; they do not "
            "change what it measures.")
    else:
        out("- **Per-session generalisation.** One session per class means every number here is "
            "within-session. A second session per class flips this script to leave-one-session-out "
            "automatically.")
    out("- **Subjects.** One subject. Nothing here says anything about another foot.")
    out("- **Path.** Everything was walked on a figure-8 in a small space; straight-line gait "
        "and its symmetric loading are unmeasured.")
    out(f"- **Cadence range.** Fast and walk are separated by contact time "
        f"({frame_a.loc[frame_a['label'] == 'fast', 'contact_time_s'].median():.2f} vs "
        f"{frame_a.loc[frame_a['label'] == 'walk', 'contact_time_s'].median():.2f} s median); "
        "intermediate cadences would blur that boundary and the CoP features would have to carry it.")
    out()
    out("Six-sensor hardware limits that data will not fix:")
    out()
    out(f"- **s4's activation threshold** turns the CoP into a five-sensor centroid on "
        f"{min(s4_frac.values()):.0%}–{max(s4_frac.values()):.0%} of stance frames, with a "
        f"{min(v[0] for v in s4_eff.values()):.0f}–{max(v[0] for v in s4_eff.values()):.0f} mm shift.")
    out("- **±15 mm sensor coordinates** on a 91 mm wide insole: every CoP distance inherits it.")
    out("- **The gain match extrapolates** above 824 counts and does not hold below ~5 N.")
    out("- **No spatial resolution between sensors**: the CoP is a weighted mean of six points; "
        "anything between them is interpolation.")
    out()
    text = "\n".join(md) + "\n"
    with open(args.doc, "w", encoding="utf-8") as f:
        f.write(text)
    print(f"\nwrote {os.path.relpath(args.doc, REPO)} and {len(os.listdir(args.fig_dir))} figures in "
          f"{time.time() - t_start:.1f} s")
    return 0


if __name__ == "__main__":
    sys.exit(main())
