parsaileslamlou/Insole/(commit log)

2026-07-10 Refactor read_serial to parse lines from file with validation
    - Add file_lines generator and serial_lines stub for later migration
    - Comment out live serial capture; drive from capture.txt for now
    - Count empty/malformed/valid rows and write valid rows to readings.csv
    - Add capture.txt sample input
2026-07-11 Add serial frame spec and gait simulator; wire up host logger
    Document the ESP32-S3 -> host wire format in framespec.md: 10-field CSV
    frame (SYNC,SEQ,TIMESTAMP,S0-S5,CHECKSUM), sum-mod-256 checksum, 100 Hz
    rate, and the ordered host-side validation gates, with the design
    rationale for each choice.
    Add gait_gen.py to emit synthetic frames (matching checksum) so the
    host pipeline can be developed without hardware.
    In read_serial.py, implement serial_lines() as a generator that resets
    the input buffer, skips warmup lines, and yields decoded lines. Check
    for empty lines before splitting, and write the parsed fields directly.
    [gait_gen.py, read_serial.py]
2026-07-11 Add gait simulator and tighten frame spec
    gait_gen.py now generates synthetic 100 Hz frames for walking and
    standing, with per-sensor stance windows, sine loading curves, and
    Gaussian noise. Writes a 60s sample to sim_walk.txt.
    framespec.md: nail down the binary-vs-CSV size numbers against actual
    simulator output, spell out why microseconds over milliseconds, and
    clarify that the checksum catches bit-flips the earlier gates miss.
    [gait_gen.py]
2026-07-12 Add ESP32-S3 firmware: 100 Hz 6-channel FSR sampler
2026-07-19 Move Sample struct into sample.h header
    Extract the Sample struct out of the sketch into a dedicated header so the
    type is visible before the Arduino builder injects auto-generated prototypes.
2026-07-20 Refactor host logger to shared parse_frame; disable firmware stub
    - read_serial.py: parse frames via gait_gen.parse_frame, track seq/timing
    breaks, and exit non-zero when acceptance criteria fail
    - insole.ino: set USE_STUB = false for real sensor sampling
    - sim_walk.txt: regenerate synthetic capture
    [insole.ino, read_serial.py]
2026-07-20 Update firmware pins and duration; add host auto-stop and noise-floor scripts
    - firmware/insole: set FSR pin values and sampling duration
    - read_serial.py: add DURATION_S auto-stop for serial capture
    - scripts: add capture_noise.py and noise_stats.py for noise-floor characterization
    [capture_noise.py, insole.ino, noise_stats.py, read_serial.py]
2026-08-07 Insole: host logger, gait sim, firmware, frame spec, docs
2026-08-07 Add session plotting and stance detection to analysis notebook
    Extends the notebook with plot_session for per-sensor session views,
    a hysteresis stance detector (T_ON/T_OFF with a minimum-duration
    filter), and plot_stances to overlay detected stances on total force.
    Thresholds are marked RETUNE pending calibration against real data.
2026-08-11 Sensor coords and time addition
2026-08-12 Guard sim generation behind __main__; rewrite README
    - gait_gen.py: only write sim_walk.txt when run directly, not on import
    - README.md: document frame format, setup, and running against sim vs board
    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
2026-08-13 Add foot pressure heatmap and stance animation
2026-08-17 Add shuffle/dropout/standing sim streams; fix true_stances cadence bug
    true_stances read the module-level CYCLE_S and treated STANCE_START/END as
    seconds rather than phase fractions, so ground truth for any non-1.0 s stride
    was wrong in both count and width. A 60 s sim_fast.txt (0.6 s stride, 100 real
    stances) scored against a truth of 60 stances 62 frames wide instead of 100 at
    37. Every P/R number computed on fast data so far was measured against that.
    cycle_s is now a parameter and the phase fractions scale with it. Adds three
    nasty streams with correct truth: shuffle (0.5 s stride, 0.45x load), dropout
    (heel channel flat zero for t=20..40 s), and standing. Dropout truth is
    deliberately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
    [gait_gen.py, read_serial.py]
2026-08-17 Move find_stances into detector.py and harden it against four failure buckets
    The detector lived only in a notebook cell, which no test file can import.
    Copying it into the test would let the two drift until the test passed against
    a stale detector, so it moves into detector.py as the single definition the
    notebook and the tests both import. SENSOR_COLS/SENSOR_COORDS come along,
    closing the duplication between heatmap.py and the notebook.
    Four fixes, each traceable to a bucket:
    - MAX_DURATION break plus an 'armed' latch: standing no longer becomes one
    6000-frame stance. The latch matters - MAX_DURATION alone re-enters on the
    next frame and converts annihilation into 25 back-to-back fals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
    [detector.py, test_stances.py]
2026-08-17 test_parse_frame: pass/fail counters and sys.exit(1)
    Carried over from Prompt 2. The script printed PASS/FAIL lines but always
    exited 0, so a regression was invisible to any caller checking exit status.
    Also resolves the import path so it runs from outside the repo root.
2026-08-17 heatmap: import SENSOR_COLS/SENSOR_COORDS from detector instead of redeclaring
2026-08-17 Notebook: import detector, add five-stream segmentation scorecard
    - find_stances/merge_close/stance_report and SENSOR_COLS/SENSOR_COORDS now
    import from detector.py; the inline copies are gone.
    - Cells point at the committed sim_*.csv streams instead of readings.csv,
    which no longer existed at the repo root.
    - feat.to_csv no longer writes over 'readings.csv'. That name was serving as
    both a raw-capture input and a feature output, so a re-run replaced the raw
    stream with the features derived from it.
    - New scorecard cell: P/R/F1 plus mean start/end/duration error per stream,
    with the caveat that on simulated data truth comes from the same constants
    that generated it, so P/R valida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
2026-08-17 Notebook: clean-clone Colab bootstrap, explain moved definitions
    Cell 0 now wipes /content/Insole and re-clones instead of fetch/reset on an
    existing checkout, so a stale clone can no longer miss a push. It also
    regenerates every sim_*.csv unconditionally and prints cwd, detector.py
    presence and the CSV list, making a half-set-up runtime obvious at a glance.
    Remaining cells gain comments recording why find_stances, SENSOR_COLS and
    SENSOR_COORDS moved to detector.py, why the scorecard reads CSVs directly
    rather than through load_sessions, why the empty stream scores NaN instead
    of zero, and why features are written to features_walk.csv.
2026-08-17 gait_gen: resolve cycle_s from mode, ignore generated session streams
    sensor_value took cycle_s=CYCLE_S and then overwrote it with SHUFFLE_CYCLE_S
    inside the shuffle branch, so an explicit cycle_s was silently discarded for
    that mode. resolve_cycle centralises the decision: an explicit value always
    wins, otherwise mode picks the default. sensor_value and true_stances resolve
    on entry, gait_lines forwards None untouched.
    This is what make_sessions.py needs to vary cadence per session -- it passes
    shuffle at 0.5 * jitter, which the old code would have flattened back to
    SHUFFLE_CYCLE_S for every session.
    .gitignore drops the generated sim_<label>_<NN>.txt sessions. The five
    unnumbered streams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
    [gait_gen.py, make_sessions.py]
2026-08-17 firmware: record the pin mapping as confirmed, not provisional
    PINS has held the soldered mapping {4,5,6,7,8,3} since 60815e1, but the
    comment above it still read "TODO: confirm against the assembled hardware"
    and framespec §9 still listed the mapping as pending assembly. Anyone
    debugging a bad channel would have had to re-derive whether the table was
    trustworthy before they could rule it out.
    Both now state the mapping is confirmed against the board. Sensor coordinates
    stay open: assembly fixed which GPIO carries which channel, not where on the
    foot each sensor sits, and centre of pressure depends on the latter.
    [insole.ino]
2026-08-18 README: update status to bring-up, document detector and sessions
    The board is assembled and the pin mapping is confirmed, so the pre-hardware
    framing no longer holds. Move the pin-mapping entry out of Open items but keep
    sensor coordinates there -- assembly fixed the wiring, it did not measure
    placement.
    Also adds detector.py, make_sessions.py and test_stances.py to the layout
    table, the three adversarial sim streams, and the data-file rules now that the
    notebook reads sim_*.csv instead of the untracked readings.csv.
2026-08-18 Add BLE (Nordic UART) streaming alongside serial capture
    - firmware/insole: stream frames over BLE NUS on core 0 in addition to USB CDC
    serial; raise baud to 921600; sum ts_us at full 64-bit width in the checksum
    - read_serial.py: add selectable serial/file/ble line sources (bleak) with
    transport-aware frame-loss gating
    - compare_captures.py: verify BLE and serial captures are byte-identical per seq
2026-08-19 read_serial: restore CLI args, parameterise the transport seam
    f690011 replaced main(argv) with main() and defaulted SOURCE to "ble", which
    dropped the positional paths. That broke insole.ipynb cell 0 and
    test_stances.ensure_csv -- both call `read_serial.py in.txt out.csv`.
    * argparse: both paths optional, --source {serial,file,ble}, defaulting to
    file when a path is given and ble otherwise, so existing calls work
    unchanged with no flags.
    * file_lines(path) no longer defaults to IN_FILE. A module constant used as a
    default argument binds at import, so reassigning it afterwards was ignored
    and the reader silently replayed capture.txt.
    * make_source() and exit_code() tak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
    [read_serial.py]
2026-08-19 features: lift the extractors out of insole.ipynb
    The six extractors existed only as notebook cells, so nothing outside Colab
    could import them -- auditing them meant exec'ing cell sources out of the
    .ipynb.
    Bodies are byte-identical to the cells they came from, mixed indentation
    included, so the two copies can be diffed. detector.py stays the single source
    of truth for the detector and sensor geometry; features.py re-exports rather
    than redeclaring.
    Verified from a clean clone: make_sessions -> read_serial -> features
    reproduces the (1123, 11) frame, equals() True against the exec'd-cell build.
2026-08-19 discriminant: guard the degenerate cases, warn on rank deficiency
    Guards only. The estimators, accuracy_ci and pooled_eigen are untouched.
    * SingularCovarianceError (subclasses LinAlgError, so existing handlers still
    catch it): _log_discriminants captured slogdet's sign and threw it away. It
    now checks it and names the offending class. slogdet moved above solve,
    which otherwise raised a bare "Singular matrix" first.
    * DegenerateClassError: fit_qda now fails at fit time when a class has
    n_k <= 1 or n_k < p, naming the class and its count. Both used to surface
    later from inside _log_discriminants at predict time.
    * IllConditionedCovarianceWarning: per-class eigenvalu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
    [discriminant.py]
2026-08-20 read_serial, discriminant: fix a BLE hang and an off-by-one guard
    BLE: _run() queued SENTINEL on each of its own exit paths, so any path it did
    not cover -- a bleak connection error, a raise inside the notify callback --
    left the consumer blocked on out.get() forever. A hang with no exit code is
    worse than a FAIL, and it was the one failure mode that could not reach
    sys.exit(1). The sentinel is now queued in one finally. on_notify() is
    unchanged, so the reassembly contract holds.
    discriminant: widen the QDA guard from n_k < p to n_k <= p. n_k centered points
    span at most n_k - 1 dimensions, so a class with exactly p samples is still
    rank-deficient. sklearn says the same ("n_samples should b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
    [discriminant.py, read_serial.py]
2026-08-20 Add bakeoff.py: session-disjoint LDA/QDA/LogReg comparison
    My LDA and QDA against sklearn's LogisticRegression and sklearn's own LDA/QDA,
    session-disjoint split, cop_path_len and cop_displacement only.
    The other five features are cadence one division removed and the classes are
    defined by changing stride period in make_sessions.py, so on the full set every
    model scores 1.000 and the comparison measures the label-generating process
    rather than the models.
    Prints every number before asserting it. n_test = 270 and pooled condition
    number 3.39 both carried over from the earlier session and both confirmed.
    Console output of the run this commit was made from, verbatim:
    ====================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
2026-08-20 notebook: import the extractors from features.py, add CoP-only list
    Cells 20-25 defined frame_dt, stance_features, cop_frame, cop_trajectory,
    cop_features and extract_features. They now live in features.py, so the six
    cells collapse to one import and the notebook stops carrying a second copy
    that drifts from the one the tests import.
    Appends COP_FEATURES = [cop_path_len, cop_displacement] for the model cells.
    Not named FEATURES: the plotting cell already binds that to a list of
    (column, label, unit) tuples and reusing the name breaks it on re-run.
    bakeoff.py calls the same list FEATURES.
2026-08-20 calibration: force model, fitting and application
    Force is linear in the conductance-transformed count, x = counts/(FS - counts),
    so force_n = a*x + b fit per sensor by least squares. Newtons everywhere in the
    API; grams are converted at the boundary and never stored.
    Three things worth calling out:
    FS_COUNTS is 4095, and that is a PLACEHOLDER, not a measurement. It is the
    arithmetic full scale of a 12-bit ADC, not the count at which this divider
    actually pins. Every conductance is wrong in proportion to how wrong it is, so
    it is overridable from the persisted JSON and per fit.
    Saturation is missing data. conductance() returns None at or above full scale
    and never clamps -- clamping would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
    [calibration.py]
2026-08-20 fit_calibration: fit all six sensors from a capture directory
    Reads cal_s{N}_{grams}g.csv, parses sensor and mass from the filename, fits all
    six, writes calibration.json, prints the per-sensor table and a 2x3 residual
    grid.
    Per file the calibration point is the MEDIAN of the steady-state window, not the
    mean. Seating the indenter spikes the start of every capture; the mean folds
    that into the point, the median ignores it as long as it stays under half the
    window. The first second is dropped outright as placement time.
    Residuals are plotted against applied load rather than against the conductance
    regressor. The shape is the same either way, but on this axis a bad point reads
    as "the 500 g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
2026-08-20 capture_calibration: record one bench load per file
    Prompts for sensor and mass, records N seconds, writes cal_s{N}_{grams}g.csv in
    read_serial's CSV layout.
    Every line source and the frame parser itself come from read_serial. This script
    does not know the wire format and must not learn it -- a second parser is a
    second thing to keep in step with framespec.md, and the two would diverge the
    first time the format moved.
    --source file replays a saved capture through the identical path, so the whole
    session can be rehearsed before anyone is at the bench waiting on it. The
    capture stops on a frame budget as well as a wall clock, since a file yields its
    whole contents instantly and a time limit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
2026-08-20 test_calibration: 38 cases over the fit, the flags and saturation
    Ground truth is a known (a, b) inverted back to counts, never fit_sensor's own
    output -- the rule test_stances.py follows with true_stances.
    Noise goes on the counts, not the masses: bench weights are known far better
    than the ADC is. Per-sample sigma is 25 counts, matching gait_gen.NOISE_STD,
    and each point is the median of a 400-sample window exactly as
    fit_calibration forms it, so what is tested is the ~1.6-count noise the fit
    actually sees rather than the raw per-sample noise.
    Tolerance is 1% on a and 0.08 N on b, about 2x the worst error over a 500-seed
    sweep of this generator (0.46% and 0.033 N). Deliberately loose: th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
    [test_calibration.py]
2026-08-25 firmware: carry the six BLE closeout fixes onto the calibration base
    Same content as the previous pass, re-applied on top of the calibration
    commits it was never based on. Six changes:
    - buildFrameLine() clamps snprintf's return to what actually landed in the
    buffer, and counts the truncation. snprintf returns the length it WANTED
    to write; handing that to Serial.write() walks off a 72-byte stack buffer.
    - notifyChunked() latches bleMtu into a local once and refuses a batch it
    cannot cut on a newline, instead of emitting a fragment the host would
    splice into a syntactically valid frame carrying wrong values.
    - bleRefused counts the batch-overflow path, which used to drop a message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
    [insole.ino, read_serial.py, sample.h]
2026-08-25 firmware: relaxed atomics for the two cross-core BLE flags
    bleConnected and bleMtuOk go from volatile bool to std::atomic<bool>, with
    memory_order_relaxed spelled out at every load and store. The default
    seq_cst would emit MEMW barriers on a path loop() touches at 100 Hz;
    relaxed compiles to the same load and store instructions volatile did.
    The volatile version was not actually racy: SRAM on the S3 is uncached,
    aligned single-word accesses cannot tear, the only genuine cross-core
    reader is bleEnqueue() reading bleConnected, and its worst case is one
    frame decided against a flag that flipped a moment later -- a frame
    bleSkippedNoConn already counts. But that argument rests on the BLE stack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
    [insole.ino]
2026-08-25 firmware: report frameTruncs on serial-only builds too
    frameTruncs belongs to the serial framing path -- it counts buildFrameLine()
    hitting MAX_LINE_LEN -- but the only place it was printed was the 1 Hz BLE
    status line, inside #if BLE_ENABLED. Build with BLE_ENABLED 0 and the counter
    still increments and nothing ever says so, which is the same as not counting
    it.
    The status block moves out of the BLE conditional; the BLE fields stay
    conditional. One line per second either way, no second status line:
    BLE_ENABLED 1 # ble conn=.. mtu=.. notif=.. drop=.. noconn=.. refused=.. trunc=..
    BLE_ENABLED 0 # ser trunc=..
    Both keep the '#' prefix, so read_serial counts them as status and not as
    m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
2026-08-25 read_serial: let a live source name its output file
    resolve_args refused a positional out_path unless --source file. argparse
    fills positionals left to right, so `--source ble out.csv` bound out.csv to
    in_path, the check saw an in_path on a live source and errored out. There was
    therefore no way to set the output path for a live capture at all, and
    compare_captures.py needs two of them running at once -- the one script whose
    entire purpose is proving BLE reassembly could not be run.
    For a live source there is no input path, so a lone positional is the output;
    re-bind it instead of refusing it. Two positionals on a live source is still
    an error.
    The restriction that ban was standing in for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
    [compare_captures.py, read_serial.py]
2026-08-25 read_serial: drop visibly at the BLE hand-off instead of blocking
    on_notify runs on the asyncio event-loop thread and called a blocking
    out.put(). maxsize=20000 is ~200 s of frames at 100 Hz so a 60 s capture
    never reaches it, but if a consumer ever does stall, blocking there stops
    notifications being serviced and the frames are lost anyway -- silently, as a
    seq gap indistinguishable from radio loss.
    put_nowait plus a counter. Same frames lost, with a number attached. That is
    the Issue D and Issue G lesson: a loss nothing reports is worse than a loss
    something reports.
    The counter is SOURCE_DROPS, module-level and deliberately generic: any source
    with a producer thread and a hand-off queue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
    [read_serial.py]
2026-08-25 test_capture_window: pin the capture anchor with a fake clock
    The regression test for the anchor fix. Stdlib only, no board, no radio, no
    real clock -- the clock and the line source are both fakes, so a 600-frame
    capture runs in milliseconds and gives the same answer every time.
    Scaled 10x down (DURATION_S 6, guard 11 s) with 8 s of fake discovery in
    front of 600 frames at 100 Hz:
    old anchor (process start) 301 of 600 written, exit 0
    new anchor (first line) 600 of 600 written, exit 0
    Verified against the old logic, not just the new one: reverting only the
    anchor hunk and re-running gives
    FAIL all 600 frames survive 8 s of discovery wrote 301, want 600
    5 passed, 8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
    [test_capture_window.py]
2026-08-25 firmware: name the BLE stack the core actually ships, with measured sizes
    The atomics note cited CONFIG_BT_BLUEDROID_PINNED_TO_CORE=0 as the default
    the volatile version's safety rested on. Core 3.3.11 does not ship Bluedroid:
    its sdkconfig has CONFIG_BT_NIMBLE_ENABLED=y and the pinning symbol is
    CONFIG_BT_NIMBLE_PINNED_TO_CORE=0. Same answer -- core 0 -- under a different
    name, which is the drift the note was hypothesising about, already happened.
    Measured on esp32:esp32:esp32s3, arduino-cli 1.5.2, core 3.3.11:
    volatile bool 599041 flash 28344 RAM
    atomic<bool>, memory_order_relaxed 599033 flash 28344 RAM (-8, 0)
    atomic<bool>, default seq_cst 599061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
    [insole.ino]
2026-09-02 fit_calibration: derive a relative gain match across the six channels
    The FSRs relax under sustained load (~31% in 76 s at constant force,
    tau ~20 min), so a multi-point absolute counts->newtons fit is not
    bench-stable. What survives the drift is the ratio between channels
    measured at one force with a common rest interval, where the shared
    relaxation cancels. derive_gain_match() selects that matched cycle from
    calibration_manifest.csv (rest >= 35 min, force in 11.4-12.1 N; exactly
    one row per sensor, asserted) and writes per-channel corrections
    k_i/mean(k) to gain_match.json, with the rows and criteria that produced
    them for provenance.
    The match is kept in its own file, never calibration.j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
    [calibration.py, fit_calibration.py, test_calibration.py]
2026-09-02 capture_calibration: scale-referenced per-trial capture
    Replace the known-mass sweep with one trial per press. The applied force
    is no longer typed in advance: press the indentor, read the load off a
    scale afterward as a [min, max] interval, and model that interval as
    uniform -> force_n = mean, sigma_force_n = (max-min)/sqrt(12).
    Each kept trial writes raw frames to cal_s{N}_t{K}.csv and appends one
    row to calibration_manifest.csv (append-only; existing rows are never
    rewritten). The manifest, not the filename, now carries sensor, force,
    and timing, which is what the scale-aware fit consumes. keep/redo/discard
    after each press so a bad seating or a fat-fingered scale entry costs one
    press,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
    [capture_calibration.py]
2026-09-02 cal_data: track the calibration dataset in git
    The blanket *.csv ignore was excluding cal_data/, which holds the 42
    calibration trial captures and calibration_manifest.csv. That data is
    hours of bench time with ~40-min rest intervals between trials, is not
    practically reproducible, and is the input to the committed gain-match
    derivation (gain_match.json) -- an untracked input to a tracked result.
    Add a !cal_data/*.csv negation so it is versioned; the blanket rule still
    covers every other CSV.
    Also record in docs/calibration_notes.md what we established about the
    frames: they are live captures, ts_us is a real esp_timer read, and the
    exactly-uniform 10 ms cadence in some files is the absolut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
    [cal_s0_t0.csv, cal_s0_t1.csv, cal_s0_t2.csv, cal_s0_t3.csv, cal_s0_t4.csv, cal_s0_t5.csv, cal_s0_t6.csv, cal_s1_t0.csv]
2026-09-03 data/real: track first measured-position gait dataset
    Add the _01 (intermittent-s0 fault) and _02 (post strain-relief, good)
    stand/walk/fast/shuffle captures -- 60 s each, 100 Hz, USB serial.
    .gitignore: change `data/` to `data/*` so a subpath under it can be
    re-included -- a bare directory exclusion cannot be overridden by a file
    negation -- then negate data/real/ and data/real/*.csv. check_all.csv
    (scratch capture) is deliberately kept ignored.
    [fast02.csv, fast_01.csv, shuffle02.csv, shuffle_01.csv, stand_01.csv, stand_02.csv, walk02.csv, walk_01.csv]
2026-09-03 data/real: add README documenting hardware, trials, and caveats
    Measured sensor positions (2026-09-02, 274x91 mm insole), the _01-vs-_02
    split and why both are kept, s4 below-threshold zeros vs missing data, the
    correlated single-frame supply glitch, and the gain_match.json calibration
    state. Flags the stale 295x74 mm figure in README.md / detector.py.
2026-09-03 geometry: derive SENSOR_COORDS from measured mm, fix insole size
    The insole is 274 x 91 mm (10.8 x 3.6 in), not the 295 x 74 mm that had been
    circulating. The old SENSOR_COORDS were placeholders and are void; the sensors
    were remeasured on a right insole lying top-up, y from the heel end and x from
    the medial edge.
    detector.py now keeps the raw millimetre table in SENSOR_MM and derives
    SENSOR_COORDS from it, so the decimals exist in exactly one place. Both axes
    divide by INSOLE_LEN_MM rather than each by its own extent: that is a
    similarity transform, so distances and CoP path lengths stay undistorted and
    a coordinate times 274 gives millimetres back. The cost is that x now spans
    [0, 0.332]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
    [detector.py, heatmap.py]
2026-09-03 geometry: frame the render to the insole box, add test_geometry
    heatmap.py was still drawing the foot into a unit square after the sensors
    moved to x in [0, 0.332]. _draw_foot now takes its xlim from
    INSOLE_WIDTH_MM / INSOLE_LEN_MM rather than a literal, and figsize is resized
    for a 0.332 x 1.0 box. set_aspect("equal") is untouched.
    The IDW grid moves onto the insole bounding box too. Gridding the unit square
    put 71% of the cells outside the mask and, worse, made each cell about three
    times wider in millimetres than it was tall, so the interpolated field was
    anisotropic in physical space. The grid is now 91 x 274 at one cell per
    millimetre: 1.011 mm across, 1.004 mm along, 21601 of 24934 ce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
2026-09-03 notebook: stop fabricating ts_us in load_sessions
    load_sessions overwrote the real ts_us column with df.index * 10000, asserting
    a perfect 100 Hz that the hardware does not deliver. Every downstream /1e6
    conversion then reported synthetic time, and any real jitter was laundered out
    before it could be measured. Deleted; nothing replaces it, because read_serial
    already carries the firmware's own timestamp through into the CSV.
    Cell 18 has a workaround naming this exact problem -- it reads the sim streams
    with pd.read_csv directly rather than through load_sessions, with a comment
    saying the helper would launder the jitter. It is now redundant. Left in place
    deliberately: removing it belongs in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
2026-09-03 docs: run the real _02 captures through the pipeline, write it up
    First non-circular test of the Prompt 9 detector. Adds analyze_real.py
    (phase C), sim_vs_real.py (phases D2-D5) and docs/sim_vs_real.md, plus the
    four comparison plots. data/real/ is read only; nothing writes back to it.
    The headline is that MAX_DURATION does not transfer. Real walk contacts have
    a median natural length of 119 frames against the 120-frame ceiling, so 17 of
    35 walk runs and 28 of 30 shuffle runs are discarded outright rather than
    clipped -- 18 and 2 stances survive. Fast is the only activity comfortably
    inside the limit and the only one detected cleanly. Thresholds were left
    exactly as they were; the writeup c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
2026-09-03 detector: raise MAX_DURATION to 200 from the real _02 captures
    At 120 the ceiling sat one frame above walk's median natural contact (119) and below almost every shuffle contact (median 141, max 164), so find_stances discarded 17/35 walk and 28/30 shuffle contacts outright. sweep_max_duration.py shows every value from 165 to 1000 keeps all of them and still rejects the 6000-frame standing run; 200 is 2.0 s, 22% above the longest observed contact.
    No sim stance exceeds 60 frames, so test_stances.py cannot see this change (15/15 before and after) and features_sessions.csv regenerates byte-identical. Real detections go walk 18 -> 35, shuffle 2 -> 30; the sim_vs_real figures are regenerated.
2026-09-03 calibration: take the extrapolation ceiling from cal_data, not a typed 940
    analyze_real.py and docs/sim_vs_real.md used ~940 counts as the highest count any calibration trial reached. Nothing in cal_data/ supports it: the highest raw sample is 824 (cal_s5_t3.csv) and the highest per-trial mean in the manifest is 809.11. CAL_MAX_COUNTS = 824 now lives in calibration.py and test_infer_live.py recomputes it from cal_data/.
    analyze_real.py also stops describing the thresholds as unretuned; it reads whatever detector.py holds and says so.
2026-09-03 read_serial: call-time defaults, --port/--duration, stall watchdog
    serial_lines, ble_lines and make_source took duration_s=DURATION_S as a default argument, bound at import, so setting read_serial.DURATION_S afterwards changed the runaway guard but not the capture length; the config comment claimed no function did this. Defaults are now None and resolve the module attribute at call time. --port and --duration are CLI flags so a machine on COM13 needs no local edit.
    STALL_S = 3.0: a live source that goes silent raises StallError and main() exits 1 with FAIL: stalled. Before this a board that stopped mid-capture produced a clean short file and exit 0. The per-line validation moved into FrameV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
    [read_serial.py, test_capture_window.py]
2026-09-03 discriminant: Wilson interval, weighted pooled_eigen, JSON save/load
    accuracy_ci was an unclipped Wald interval: zero width at acc = 1 and bounds outside [0, 1] near it. It is Wilson now, clipped; se stays the Wald standard error because bakeoff.py compares it to a session-level se. pooled_eigen averaged the QDA covariances unweighted; it now weights by n_k - 1 and equals fit_lda's pooled covariance (asserted). The n_k <= p guard was already in place (2ed8c1c); a test pins it.
    fit_lda/fit_qda return counts. save_model/load_model round-trip a model through JSON with a caller-supplied meta block. bakeoff.py prints the misclassified row indices and their overlap across the three models, which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
    [bakeoff.py, discriminant.py, test_discriminant.py]
2026-09-03 infer_live: streaming inference over the read_serial seam
    detector.StanceTracker runs find_stances + merge_close one frame at a time and reports every decision: stance, discarded_max, rejected_min. test_infer_live.py checks it against the batch detector on every sim fixture, every sim session, every real capture and 2000 random sequences, and checks that the per-stance features infer_live.py emits are bit-identical to extract_features on the CSV read_serial.py writes from the same bytes.
    infer_live.py takes --source file|serial|ble through make_source, validates with FrameValidator, applies the gain match in conductance space every frame (reported, not fed to the model), counts frames above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
    [detector.py, fit_model.py, infer_live.py, test_infer_live.py]
2026-09-03 docs: fix three stale claims, describe the CLI and the streaming script
    The s4 bias ordering in data/real/README.md was a guess (fast is second worst, shuffle has the lowest zero fraction of the moving three). bakeoff.md's 'same error, 9 rows' was wrong: 7/3/6 fast->walk rows with 3 common, and the accuracies are 0.9037/0.9296/0.9259 under the measured geometry. docs/sim_vs_real.md's ~940 calibration ceiling is 824, and its C5/C6/D2-D5 tables are marked as the MAX_DURATION=120 record. README's capture section described a constants-only read_serial that has had argparse for some time.
2026-09-03 gait_gen: seeded drop, corrupt and reset fault modes; count and flag them downstream
    Three flag-controlled fault modes on any simulated stream, off by default and
    byte-identical with them off (twelve session hashes pinned). The shared
    FrameValidator counts a board reset once from the device clock running
    backwards, credits bad-checksum frames against the sequence gap they leave so
    valid + lost + bad_checksum equals the frames emitted, and exposes the per-frame
    gap so infer_live can flag a stance with a hole in it. StanceTracker.reset()
    discards the run in progress at a reboot. A reset now fails the capture on every
    transport. test_faults.py feeds the same faulty stream to the logger and the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
    [detector.py, gait_gen.py, infer_live.py, read_serial.py, test_faults.py, test_stances.py]
2026-09-03 repo: consolidate into the insole package, scripts/, tests/, notebooks/, models/
    Package modules are the ones a test or another module imports; programs that
    are only run live in scripts/. Paths resolve through insole/paths.py instead of
    the working directory, the sim fixtures and every generated sim file live in
    data/sim/, and the notebook's first cell clones on Colab or walks up to the
    checkout locally. Two invocation forms, used consistently: python -m
    insole.<module> and python scripts/<name>.py. The regenerating scripts print
    identical numbers from the new layout; the suite is unchanged at 265 script
    PASS lines and 40 pytest functions. README rewritten around the new tree.
    [analyze_real.py, bakeoff.py, calibration.py, capture_calibration.py, compare_captures.py, detector.py, discriminant.py, features.py]
2026-09-03 train_real: classifier on the real _02 captures; ship conductance features
    scripts/train_real.py segments the four real captures on raw counts, computes
    features.py's extractors under raw counts, conductance and gain-matched
    conductance, fits LDA/QDA/LR on CoP-only and full feature sets, and scores a
    time-blocked within-session split (one session per class makes a per-session
    split impossible) beside a random stance split and contiguous-block CV. One
    headline cell is chosen by a rule fixed before the run: CoP-only, best
    block-CV among LDA/QDA. That was conductance/QDA, 0.6444 [0.4984, 0.7678] on
    45 test stances against a 0.4222 floor, with walk recall 0.071; the document
    lists every misclass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
    [bakeoff.py, fit_model.py, infer_live.py, representations.py, sim_vs_real.py, splits.py, test_infer_live.py]
2026-09-03 notebooks: add the run-all demo with the heatmap GIFs and the CoP agreement check
    Spec, generate, log, calibrate, segment, features, predict, stream, heatmap and
    faults in order, each with a one-line reason, seeded, executed without hardware
    in a few seconds and committed with outputs. The two GIFs (simulated walk and
    real walk02, sixth stance each) keep every third frame at 10 fps, i.e. 0.3x
    real time, with a fixed per-panel colour scale in conductance units and the CoP
    trail under the same representation; a cell asserts the overlay's displacement
    equals features.py's cop_displacement exactly. README links it as the start.
2026-09-03 final pass: run_demo.sh, hardware notes, README truth-check
    run_demo.sh chains generate, log and predict on a seeded simulated walk under
    set -euo pipefail, prints one DEMO OK line and exits nonzero on any failure.
    docs/hardware_notes.md compiles the board, bench, calibration rig, relaxation,
    collection protocol and every failure mode observed, each number naming its
    tree location or marked as a session note. README gains the demo script, the
    hardware notes and the final status rows; docs/real_results.md drops the
    per-run git hash from its header (the model meta keeps it).
    [train_real.py]
2026-09-04 bench: stage-14 live serial and BLE runs
    [ble_logger.csv, ble_logger_attempt1_stalled.csv, ble_logger_attempt2_stalled.csv, ble_preds.csv, press.csv, press_medial.csv, press_s5.csv, serial_logger.csv]
2026-09-04 data/real: add the _03 session set, a second session per class
    [fast_03.csv, shuffle_03.csv, stand_03.csv, walk_03.csv]
2026-09-04 train_real: pin stances per file, switch to leave-one-session-out
    The stance guard summed stances per label and asserted the _02 totals, so
    the _03 set made it abort on walk 67 vs 35. It now pins every training-grade
    capture by file (SESSIONS, mirrored by REAL_COUNTS in test_stances.py) and
    refuses a capture that has no pin, so a new session never moves an old pin.
    With two sessions per class the script switches to leave-one-session-out:
    fold k holds out session k of every class, every stance is tested once out
    of its own session, and the headline pools the folds. The within-session
    time-blocked split and the random split are kept beside it as the
    optimistic references; splits.py now groups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
2026-09-04 tests: assert in the pytest wrappers, keep the PASS/FAIL counts
    The nine script-style test files returned (passed, failed) tuples from their
    test_* functions, so pytest printed 37 PytestReturnNotNoneWarning and passed
    every function whatever the checks said; the five red checks the _03 set
    caused were invisible to it. Each counting function is now check_*, the
    test_* wrapper of the same name asserts nothing failed, and the direct run
    prints the same PASS/FAIL lines and totals as before. test_parse_frame's
    nine checks ran only as a script; they are under pytest now too. Nothing
    about what is checked changed.
    [test_calibration.py, test_capture_window.py, test_faults.py, test_geometry.py, test_infer_live.py]
2026-09-04 infer_live: default to the real-trained model, sim model by flag
    The default was the sim-trained LDA, which scores below the majority floor
    on real captures. It is models/model_qda_real.json now; models/model_lda.json
    stays reachable with --model, and run_demo.sh names it explicitly because it
    replays a simulated stream. The banner reads the model's meta instead of
    assuming simulation: it prints the split and the held-out number the model
    carries, warns when the model is sim-trained, and notes the plumbing-check
    status of a real model on simulated frames.
2026-09-04 docs, scripts: stage numbering, frame_spec name, tool ignores out of the tree
    Stage numbers replace the old prompt numbers in docstrings and banners (the
    mapping is one to one with the README's status table), two references to
    framespec.md now name docs/frame_spec.md, and the ignore rules for local
    editor tooling move from .gitignore to .git/info/exclude.
    [analyze_real.py, capture_calibration.py, make_sessions.py, sim_vs_real.py]
2026-09-04 docs: regenerate every number the second session moved
    The _03 set and the leave-one-session-out split move every headline figure,
    so real_results.md is regenerated by the script and the rest is brought in
    line with it.
    sim_vs_real.md stays the stage-13 record on the _02 set, but its C5, C6,
    D2-D5 tables were still the MAX_DURATION=120 output while the detector has
    been at 200 since. They now carry the current numbers, with the 120-era
    tables kept inside C5 where they are the evidence for finding 1 (walk 35 not
    18, shuffle 30 not 2; D2 0.3097/0.2566 on 113 stances, D4b 28.9x/2.62 mm).
    hardware_notes.md replaces "what the live bench must show" with what it
    showed, read from data/bench/: fou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
2026-09-04 representation: the model names it, the loader honours it
    The model file format was deciding which representation the project could
    ship. infer_live computed features under representations.SHIPPED and refused
    any model naming another, so the persisted real models had to be fitted under
    B for the streaming path to accept them -- and the pre-registered rule, which
    prefers A on the two-session data, could not produce a loadable model. Fix the
    mechanism, not the choice.
    Every model JSON now records "representation". infer_live reads it and applies
    the matching transform on every source, and refuses, naming both sides, only a
    model whose representation it cannot honour: an absent field (a pre-st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
    [infer_live.py, test_infer_live.py, train_real.py]
2026-09-04 scope: mark the _02-only records, say the _03 pins are pins, skip on missing artifacts
    analyze_real.py, sim_vs_real.py and docs/sim_vs_real.md read the _02 set only
    and did not move when the _03 session landed. Without a banner they read as
    current. Each now opens by saying it is the stage-13 record on the _02 set,
    that nothing in it reflects the two-session results, and where the current
    numbers live.
    test_stances' real-capture counts say what they are: pins read off the
    detector, not independent ground truth. There is no hand-labelled truth for
    the real captures, so green means unchanged, not correct -- a detector that
    merged two real steps would have been pinned merging them and would pa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
    [analyze_real.py, sim_vs_real.py, test_stances.py]
2026-09-04 bench: record each run's exit code, label the derived ones as derived
    The stage-14 bench was four commands typed by hand, and their logs end at
    read_serial's summary line, so no exit status was ever written down. The exit
    column in hardware_notes was DERIVED afterwards by feeding each log's counters
    back through read_serial.exit_code. That derivation is sound for what it
    covers and is still not an observation: it cannot see a process that exited
    nonzero for a reason the counters do not describe. hardware_notes now says so,
    and the four zeros are labelled inferred.
    scripts/bench_capture.sh runs the same four commands and appends exit=<code>
    to each log, captured the instant the command retur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
2026-09-04 README, writeup: the interval is a floor, the rule did not pick B, both denominators
    Every place the pooled interval appears now says why it is a lower bound on
    the uncertainty and not a confidence interval for a new session, naming the
    violation rather than gesturing at small samples: 224 correlated stances from
    2 sessions of 1 subject treated as 224 independent observations.
    The A-vs-B open item is rewritten. It had implied the shipped choice was the
    rule's; it was not. The rule prefers A by two stances in 224, the intervals
    overlap over 93% of their length, the two are statistically indistinguishable
    on this data, and B is retained as a pre-existing stage-20 freeze.
    Both denominators tr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
2026-09-04 notebooks: re-run both top to bottom, regenerate the demo GIFs
    demo.ipynb section 7 pulled four paragraphs out of real_results.md by prefix
    and truncated each at 600 characters. One of those prefixes no longer exists,
    and truncation cut the statements that qualify the numbers. It now quotes
    seven paragraphs whole, wrapped rather than clipped -- the rule's verdict, why
    B is still shipped, the interval caveat, the two denominators -- and prints a
    MISSING list if a prefix stops matching, so a regenerated document that drops
    a paragraph is visible instead of silent.
    Its section 7 prose says the intervals are floors and that the rule picked A,
    not B.
    Both notebooks re-run top to bottom with out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
2026-09-04 Close the open list: BLE failure path, both estimators, final counts
    read_serial.ble_lines now surfaces a reader-thread failure instead of
    printing it and returning a short capture. The exception is parked in a
    list, the consumer drains every line the thread managed to queue, and then
    re-raises it, so a dead radio produces a traceback and a nonzero exit
    rather than a capture that looks clean. A _runner= seam replaces the BLE
    session with a caller-supplied coroutine, and the bleak import moved inside
    _run() so exercising that path needs neither a radio nor bleak installed.
    ble_lines is the only definition in the file that changed; the other twelve
    are byte-identical, and the success path is u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
    [read_serial.py, test_infer_live.py]
2026-09-05 README: show the build, point at the demo-v1 release
    The demo-v1 release carries three photographs of the rig and a recorded
    walkthrough video. Nothing in the tree referenced them, so the README showed
    none of it.
    figures/hardware/ holds the three photographs downscaled to 1600 px (about
    500 KB each, in line with the committed figures/demo GIFs); the Hardware
    section shows them above the pin and sensor-placement tables they illustrate.
    The originals are 24 MP phone shots, 13 MB each, and the video is 37 MB: those
    stay on the release rather than in git history, and the README links there for
    them.
    No capture figure from the release notes is repeated here; nothing in this
    repository measures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
2026-09-06 README: restructure for a reader deciding whether to read on
    The README was 6,061 words and put the first result at line 359 of 624. It
    was written for an auditor verifying every claim, not for someone deciding in
    ninety seconds whether the project is worth their time. Both readers matter;
    only the first was served.
    - Lead with the real-walk pressure heatmap. figures/demo/heatmap_real_walk.gif
    already existed and was in no document; the only images were three static
    hardware photos two hundred lines down.
    - Move the results above the fold, as a table against the majority-class
    baseline, with the walk/fast failure and the simulator's circularity stated
    in plain language rather than l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
